FabioCL/analog_synth/simulations/LMx58B_LM2904B_PSpice/LMx58B_LM2904B-PSpiceFiles/SCHEMATIC1/Transient/Transient.cir

** Profile: "SCHEMATIC1-Transient"  [ C:\Users\a0232807\Documents\Modeling\model_fix_reupload\LMx58B_LM2904B-PSpiceFiles\SCHEMATIC1\Transient.sim ] 

** Creating circuit file "Transient.cir" 
** WARNING: THIS AUTOMATICALLY GENERATED FILE MAY BE OVERWRITTEN BY SUBSEQUENT SIMULATIONS

*Libraries: 
* Profile Libraries :
* Local Libraries :
.LIB "../../../fixed_models/lmx58b_lm2904b.lib" 
* From [PSPICE NETLIST] section of C:\cds_spb_home\cdssetup\OrCAD_PSpiceTIPSpice_Install\17.4.0\PSpice.ini file:
.lib "nom_pspti.lib" 
.lib "nom.lib" 

*Analysis directives: 
.TRAN  0 1m 0 
.OPTIONS ADVCONV
.OPTIONS FILEMODELSEARCH
.PROBE64 N([VO])
.PROBE64 N([VIN])
.INC "..\SCHEMATIC1.net" 


.END
