FabioCL/analog_synth/simulations/main_trim_and_linexp.asc

C3: cap; 1n
Q3: npn; BC547C
Q4: npn; BC547C
R1: res; 1200k
R2: res; 100k
R3: res; 2.2k
R4: res; 1
R5: res; 623
R6: res; 15k
R7: res; 100k
R8: res; 100k
R9: res; 10k
R10: res; 1
R11: res; 1780
U1: LMX58B_LM2904B
U2: LMX58B_LM2904B
U4: LMX58B_LM2904B
V5: voltage; {vpitch_val}
V6: voltage; -12V
V7: voltage; 12V
V8: voltage; 5V
X1: pot; R=100k val=50
X2: pot; R=100k val=50
Named nets: 0, Vneg, Vpos, CV_out, Vpitch, GND, VCC, Vpitch_trim
based on https://www.schmitzbits.de/expo_tutorial/
Create audio files
https://www.analog.com/en/analog-dialogue/raqs/raq-issue-175.html
Linear to Exponential Converter
1st order Temp compensation: Current mirror Is argument
The exponentiator has the lowest
 temperature dependancy
when operated arround Is
( reference current).
2nd order Temp Comp: exp argument
Rbe effect (Rossum compensation)
Coarse
Fine
Pitch 1V/oct
.step param vpitch_val 0 5 1
.op
No Temperature compensation (25C assumed)
just for visualization
