FabioCL/analog_synth/simulations/main_ADSR.asc

20: res; 20k
C1: cap; 470p
C2: cap; 4.7µ
C3: cap; 470p
C4: cap; 220n
C5: cap; 33n
D1: diode; 1N914
D2: diode; 1N914
D3: diode; 1N914
D4: diode; 1N914
D5: diode; 1N914
D6: diode; 1N914
D7: diode; 1N914
D8: diode; 1N914
D9: diode; 1N914
D10: diode; 1N914
D11: diode; 1N914
D12: diode; 1N914
D13: diode; 1N914
D14: diode; 1N914
D16: diode; 1N914
Q1: npn; BC847B
Q2: npn; BC847B
Q3: pnp; 2N2907
Q4: npn; BC847B
Q5: npn; BC847B
Q6: pnp; 2N2907
Q7: pnp; 2N2907
Q8: npn; BC847B
Q9: pnp; 2N2907
R1: res; 1k
R2: res; 50000k
R3: res; 39k
R4: res; 39k
R5: res; 1000k
R6: res; 270k
R7: res; 100k
R8: res; 39k
R9: res; 39k
R10: res; 100k
R11: res; 20k
R12: res; 270k
R13: res; 27k
R14: res; 1000k
R15: res; 270k
R16: res; 3.6k
R17: res; 20k
R18: res; 39k
R19: res; 39k
R20: res; 39k
R21: res; 270k
R22: res; 100
R23: res; 270k
R26: res; 10k
R27: res; 30k
R28: res; 50.1k
R29: res; 10k
R30: res; 100k
U1: UniversalOpAmp
U2: UniversalOpAmp
V2: voltage; PULSE(0 5 1 100p 0 1)
V6: voltage; -12V
V7: voltage; 12V
X1: pot; R=5000k val=80
X2: pot; R=1000k val=90
X3: pot; R=1000k val=50
X4: pot; R=100k val=50
X6: pot; R=1k val=10
Named nets: 0, Vneg, Vpos, gate_in, B, B_plus, Q, A_plus, Cbuf, C, OUT_aux, OUT, OUT_INV, OUT_AMT
.tran 10 startup
Input SCHMITT
ADSR driver
MMBT2907A - sot23
SUSTAIN level
ATTACK time
RELEASE time
DECAY time
Output SCHMITT
Attack Flip-flop
OUTPUT buffer
Cbuf is a sample of the
 output voltage
Goes low when ATTACK ends (Cout = 8v)
Positive pulse when B goes high
Q keeps track of the ATTACK phase.
between pulses B_plus and A_plus (turns OFF)
