FabioCL/analog_synth/simulations/Draft1.asc

D1: diode
D2: diode
D3: diode
M1: pmos; IRF7220
M2: nmos; BSC059N04LS6
M3: nmos; BSC059N04LS6
M4: nmos; BSC059N04LS6
R1: res; 10
R2: res; 10
R3: res; 10
V1: voltage; PULSE(0 3.3 0.5 0 0 1 6)
V2: voltage; PULSE(0 3.3 1 0 0 1 3)
V3: voltage; 3.3V
V4: voltage; PULSE(0 3.3 1 0 0 1 3)
V5: voltage; PULSE(0 3.3 1 0 0 1 3)
Named nets: 0, EN, VCC, CLR1, CLR3, CLR2, LED1, LED2, LED3, LEDs_EN
.tran 10
