FabioCL/analog_synth/simulations/main_LPF_Ladder.asc

C1: cap; 1µ
C2: cap; 1n
C3: cap; 1n
C4: cap; 1n
C5: cap; 1n
C6: cap; 1n
C7: cap; 1µ
D1: diode; 1N914
D2: diode; 1N914
D3: diode; 1N914
D4: diode; 1N914
D5: diode; 1N914
D6: diode; 1N914
D7: diode; 1N914
D8: diode; 1N914
D9: diode; 1N914
D10: diode; 1N914
D11: diode; 1N914
R1: res; 1k
R2: res; 4.7k
R3: res; 100
R4: res; 47k
R5: res; 47k
R6: res; 47k
R7: res; 47k
R8: res; 47k
R9: res; 47k
R10: res; 1k
R11: res; 47k
R12: res; 100k
R13: res; 47k
R14: res; 1k
R15: res; 47k
R17: res; 10k
R18: res; 2.7k
U1: LMX58B_LM2904B
U2: LMX58B_LM2904B
U3: LMX58B_LM2904B
U4: LMX58B_LM2904B
U5: LMX58B_LM2904B
U6: LMX58B_LM2904B
U7: LMX58B_LM2904B
V1: voltage; ""; AC 1
V2: voltage; 12
V3: voltage; PULSE(-5 5 0 1p 1p {wton} {wperiod})
V6: voltage; -12V
V7: voltage; 12V
X1: pot; R=100k val={cutf_val}
X2: pot; R=100k val=50
Named nets: 0, Vneg, Vpos, signalwave, offset, ladder_p, CV_CUT_OFF, signal_buffer, ladder_n, ladder_out, amp_out, ladder_buff, ladder_res_out, ladder_res, VIN, VOUT
.ac dec 999 10 20k
Wave Preparation
 - HP filter (DC remove)
 - Signal down scaling (prevent ladder to become a short circuit " resistor too low")
Diode LADDER
Gain = 1, Positive offset
Inverter Summer
100mVpp
output gain stage
CV Processing - Cutoff Frequency / Change "diode" resistance
Ressonance
;.step param res_val 10 90 80
reduce diodes effective resistances  (voltage controlled resistor)
.param wfreq=1200 wperiod=1/wfreq wton=wperiod*0.5
.step param cutf_val 10 90 10
