FabioCL/analog_synth/simulations/main_SAW_to_PULSE_PWM_SQUARE.asc

C1: cap; 10n
R1: res; 1k
R2: res; 100k
R3: res; 1k
R4: res; 1k
R5: res; 2.4k
U1: TL07XH_TL08XH
U2: TL07XH_TL08XH
V1: voltage; PULSE(-5 5 0 {period} 0 0 {period})
V2: voltage; 5V
V6: voltage; -12V
V7: voltage; 12V
X1: pot; R=100k val=50
Named nets: 0, Vneg, Vpos, Vsaw_in, Vpulse, Vcc, Vpulse_out
.tran 12ms
.param period=1/110
DC control
Output range: -5V to 5V
Output: 0
