FabioCL/analog_synth/simulations/main_SAW_to_SQUARE.asc

U1: TL07XH_TL08XH
V4: voltage; PULSE(-2.4 2.4 0 {triangle_period/2} {triangle_period/2} 0 {triangle_period})
V6: voltage; -12V
V7: voltage; 12V
Named nets: 0, Vneg, Vpos, Vtriangle_in, Vsine
.tran 12ms
Saw to Sine (OTA)
https://www.youtube.com/watch?v=V_AzBAopRS8&list=PLOunECWxELQS5bMdWo9VhmZtsCjhjYNcV&index=19
.param triangle_period={1/val}
Sine wave
 - Linearizing diode, 1mA bias is recommended, (12 - 0.7V)  10k recommended
 - gm = 19.2* Iabc
.step param val list 220 880
