FabioCL/analog_synth/simulations/main_SAW_to_TRIAN.asc

C1: cap; 100p
C2: cap; 100p
D2: diode; 1N914
D3: diode; 1N914
R1: res; 10k
R2: res; 10k
R3: res; 10k
R4: res; 10k
R5: res; 10k
R6: res; 1k
R7: res; 4.7k
R8: res; 10k
R9: res; 20k
R10: res; 1k
R11: res; 1k
U1: TL07XH_TL08XH
U2: TL07XH_TL08XH
U3: TL07XH_TL08XH
U5: TL07XH_TL08XH
V1: voltage; 1.2
V2: voltage; PULSE(0 4.8 0 {period} 0 0 {period})
V3: voltage; 1.2
V6: voltage; -12V
V7: voltage; 12V
Named nets: 0, Vneg, Vpos, Vsaw_in, Vsaw_ac_inv, Vref, Vtriangle_AC, Vsaw_ac, Voffset, Vtriangle_out, Vsaw_out
VCO  (Exp input) based on
.param period=1/220
.tran 12ms
trimming
SAW/Ramp wave
Saw to Pulse Wave ( Moog Werkstatt)
https://www.youtube.com/watch?v=qsaLmGgiVcU
Triangle wave
Output Range: 0 to 5V
Phase: 0deg
