FabioCL/analog_synth/simulations/main_TRIAN_to_SINE2.asc

C1: cap; 1µ
D1: diode; 1N914
D2: diode; 1N914
R10: res; 10k
R11: res; 10k
R12: res; 2.2k
R13: res; 10k
U2: TL07XH_TL08XH
V4: voltage; PULSE(-5 5 0 {triangle_period/2} {triangle_period/2} 0 {triangle_period})
V6: voltage; -12V
V7: voltage; 12V
X1: pot; R=100k val=90
Named nets: 0, Vneg, Vpos, Vtriangle_in, sine_wave_ac
.tran 0 100ms 60ms uic
.param triangle_period={1/val}
.step param val list 220 880
;.step param r_val 10k 100k 10k
Variable - Gain
Variable - Curvature
