FabioCL/analog_synth/simulations/main_trim.asc

B1: bv; V=(V(vpitch_trim))-(V(vpitchref))
B2: bv; V=-V(vpitch)*({Ru}/{Rin})
R1: res; 1100
R2: res; 8250
R5: res; 100k
R6: res; 1k
R7: res; 100k
R8: res; 1100
R9: res; 8250
R10: res; 100k
U1: LMX58_LM2904
U2: TFPT0805L2201; TOL25=1 TOLslope=0
U3: TFPT0805L2201; TOL25=1 TOLslope=0
V1: voltage; {vpitch_val}
V2: voltage; -12V
V3: voltage; 12V
V4: voltage; 5V
V6: voltage; 1V
X1: pot; R=100k val=49.171
X2: pot; R=100k val=50
Named nets: Vneg, Vpos, Vpitch, Vpitch_trim, GND, 0, vpitch_error, VCC, vpitchref, 1V0_B
Control Voltage
Coarse
Fine
Pitch 1V/oct
Note: 
To get 1V / octave. Gain should be 18mV/V 
(required by the transistor next stage)
 
Opamp offset fixed by course and fine tune
.meas VtrimAvg AVG V(vpitch_trim)/V(vpitch)
.step param vpitch_val 0.5 5 0.5
.op
.param Rin=100k Ru=1.8k
Temperature compensation
.TEMP 10 25 45
