FabioCL/analog_synth/simulations/main_trim_and_linexp_temp.asc

R2: res; 100k
R7: res; 100k
R8: res; 100k
R9: res; 10k
R12: res; 1100
R13: res; 8250
U2: LMX58_LM2904
U5: TFPT0805L2201; TOL25=1 TOLslope=0
V5: voltage; {vpitch_val}
V6: voltage; -12V
V7: voltage; 12V
V8: voltage; 5V
X1: pot; R=100k val=50
X2: pot; R=100k val=50
Named nets: Vneg, Vpos, Vpitch, Vpitch_trim, GND, 0, VCC
based on https://www.schmitzbits.de/expo_tutorial/
Linear to Exponential Converter
Coarse
Fine
Pitch 1V/oct
Note: 
To get 1V / octave. Gain should be 18mV/V 
(required by the transistor next stage)
 
Opamp offset fixed by course and fine tune
.step param vpitch_val 0.5 5 0.5
.op
Temperature compensation
.TEMP 10 25 45
