FabioCL/analog_synth/simulations/main_VCA_exp.asc

Q3: npn; BC547C
Q4: npn; BC547C
R1: res; 10k
R2: res; 100
R3: res; 47
R4: res; 6.8kk
R5: res; 100k
R6: res; 10k
R7: res; 10k
R8: res; 10k
R9: res; 47k
R10: res; 100k
R11: res; 47k
R12: res; 100k
R13: res; 6.8k
U1: TL07XH_TL08XH
U2: TL07XH_TL08XH
V1: voltage; EXP(0 5 0 1 2 1)
V2: voltage; PULSE(0 5 0 2 2 1)
V3: voltage; SINE(0 5 100)
V4: voltage; -400m
V6: voltage; -12V
V7: voltage; 12V
Named nets: 0, Vpos, Vneg, CV_in_notused, signalwave, CV_in, vout1, vout2, emit, vout, Vr
.tran 2s
Vin Signal -5 to 5V
AMP mag input
Vctrl Signal -5 to 5V
ADSR input
;.wave test1.wave 16 44100 vout
;.wave test1.wav 16 44100 vout
Define exponential curvature / acentuation
gain relation / Lin to Exp
TODO:add 1v offset
Vout = Vr + ((Rf/R1) * (V2 -V1))
