FabioCL/analog_synth/simulations/main_VCA_linear.asc

Q3: npn; BC547C
Q4: npn; BC547C
R1: res; 10k
R2: res; 100
R3: res; 1k
R4: res; 10k
R5: res; 100k
R6: res; 10k
R7: res; 100k
R8: res; 100k
R9: res; 360k
R10: res; 100k
R11: res; 360k
U1: TL07XH_TL08XH
U2: TL07XH_TL08XH
V1: voltage; PULSE(0 12 0 100m 0 0.1)
V3: voltage; SINE(0 5 440)
V6: voltage; -12V
V7: voltage; 12V
Named nets: 0, Vpos, Vneg, CV_in, signalwave, vout1, vout2, emit, vout
based on https://www.schmitzbits.de/expo_tutorial/
Linear to Exponential Converter
.tran 100m
Vin Signal -5 to 5V
AMP mag input
Vctrl Signal -5 to 5V
ADSR input
.wave
