FabioCL/analog_synth/simulations/main_VCA_linear_transistorbased.asc

Q3: npn; BC547C
Q4: npn; BC547C
R1: res; 10k
R2: res; 100
R3: res; 1k
R4: res; 47k
R5: res; 100k
R6: res; 10k
R7: res; 10k
R8: res; 10k
R9: res; 68k
R10: res; 100k
R11: res; 68k
U1: TL07XH_TL08XH
U2: TL07XH_TL08XH
V1: voltage; EXP(0 5 0 1 2 1)
V3: voltage; SINE(0 5 440)
V6: voltage; -12V
V7: voltage; 12V
Named nets: 0, Vpos, Vneg, CV_in, signalwave, vout1, vout2, emit, vout
.tran 10s
Vin Signal -5 to 5V
AMP mag input
Vctrl Signal -5 to 5V
ADSR input
brief ADSR sim
.wave test1.wave 16 44100 vout
.wave test1.wav 16 44100 vout
