FabioCL/analog_synth/simulations/main_VCO_SAW.asc

C1: cap; 1µ
C2: cap; 2.2n
C3: cap; 22p
I1: current; 1.98E-05
J2: njf; 2N4859
R1: res; 22k
R2: res; 2.2k
R3: res; 100k
R4: res; 10k
R5: res; 20k
R6: res; 1k
R7: res; 10k
R8: res; 10k
R9: res; 1k
U1: TL07XH_TL08XH
U2: LM311
U3: TL07XH_TL08XH
U4: TL07XH_TL08XH
V6: voltage; -12V
V7: voltage; 12V
X1: pot; R=100k val=33.2
X2: pot; R=100k val=43
Named nets: 0, Vneg, Vpos, Vsaw, Vpulse, Vsaw_out_inv, Vsaw_out
https://www.youtube.com/watch?v=qF4G4QfC9dM&list=PLOunECWxELQS5bMdWo9VhmZtsCjhjYNcV&index=12
VCO  (Exp input) based on
;step param ifreq list 1.98E-05 3.96E-05 7.92E-05 1.58E-04 3.17E-04
.tran 100m
Vgs(OFF) = -2.2V
.MODEL 2N4859 njf VTO=-4.92 BETA=2.42m LAMBDA=25.4m CGD=10.9p CGS=10.9p PB=1.68 IS=22.1f MFG=InterFET
Output Range: -5 to 5V
Phase: 0deg
Output Range: -5  to 5V
Phase: 180deg
