FabioCL/analog_synth/simulations/pot.asc

R1: res; {x1}
R2: res; {x2}
Named nets: 1, 3, 2
.param x1 = R*(val/100)
.param x2=R*(1-(val/100))
