FabioCL/analog_synth/simulations/ltspice_ntc_tfpt_pts_model/Draft1.asc

R1: res; 450
R2: res; 2000
U1: NTCS0805E3102_LT
V1: voltage; 10
Named nets: 0
.dc TEMP -40 125 1
