FabioCL/analog_synth/simulations/ltspice_ntc_tfpt_pts_model/simulation_LT_therm_Vishay.asc

R1: res; 1k
R2: res; 8k
R3: res; 10k
U1: TFPT1206L1002; TOL25=1 TOLslope=1
U3: PTS12060__1K00; TOL0=0.6 TOLS=0.01
U4: NTCS0805E3102_LT; NTCS0603E3102_LT; TR=5 TB=1
V1: voltage; 0.2
V2: voltage; 0.2
V3: voltage; 0.2
Named nets: 0, TFPT, PTS, NTC
.dc TEMP -55 150 1
.param run=1
.step param run 1 100 1
.meas Rt1 find -V(TFPT)/I(V1) at=-55
.meas Rt2 find -V(TFPT)/I(V1) at=25
.meas Rt3 find -V(TFPT)/I(V1) at=85
.meas Rt4 find -V(TFPT)/I(V1) at=150
.meas Rn1 find -V(NTC)/I(V3) at=-55
.meas Rn2 find -V(NTC)/I(V3) at=25
.meas Rn3 find -V(NTC)/I(V3) at=85
.meas Rn4 find -V(NTC)/I(V3) at=150
.meas Rp1 find -V(PTS)/I(V2) at=-55
.meas Rp2 find -V(PTS)/I(V2) at=0
.meas Rp3 find -V(PTS)/I(V2) at=85
.meas Rp4 find -V(PTS)/I(V2) at=150
.meas B PARAM -ln(Rn2/Rn3)/(1/358.15-1/298.15)
This simulation is computing and displaying the voltages 
across an NTC Thermistor, across a TFPT RTD and also
a PTS RTD in a voltage divider (Vcc= 0.2 V in order to 
avoid self heating) , for temperatures swept between -55°C
and 150°C.  100 runs are performed,the tolerances being 
modelled according to Monte Carlo distribution.
In the MEAS section , resistances are computed at different
temperatures (-55°C/150°C) .When the simulation is completed ,
open "view" then "Spice Error Log" for display.
