FabioCL/analog_synth/(list of files, drawings)

Other design files:
simulations/LMx58B_LM2904B_PSpice/lmx58b_lm2904b.dsn
simulations/LMx58B_LM2904B_PSpice/lmx58b_lm2904b.opj
