FabioCL/analog_synth/hardware/kicad_project/hybrid_core_module/midi_vco_module/midi_vco_module.kicad_pcb

## KiCad design hardware/kicad_project/hybrid_core_module/midi_vco_module/midi_vco_module.kicad_pcb (2025-11-15)

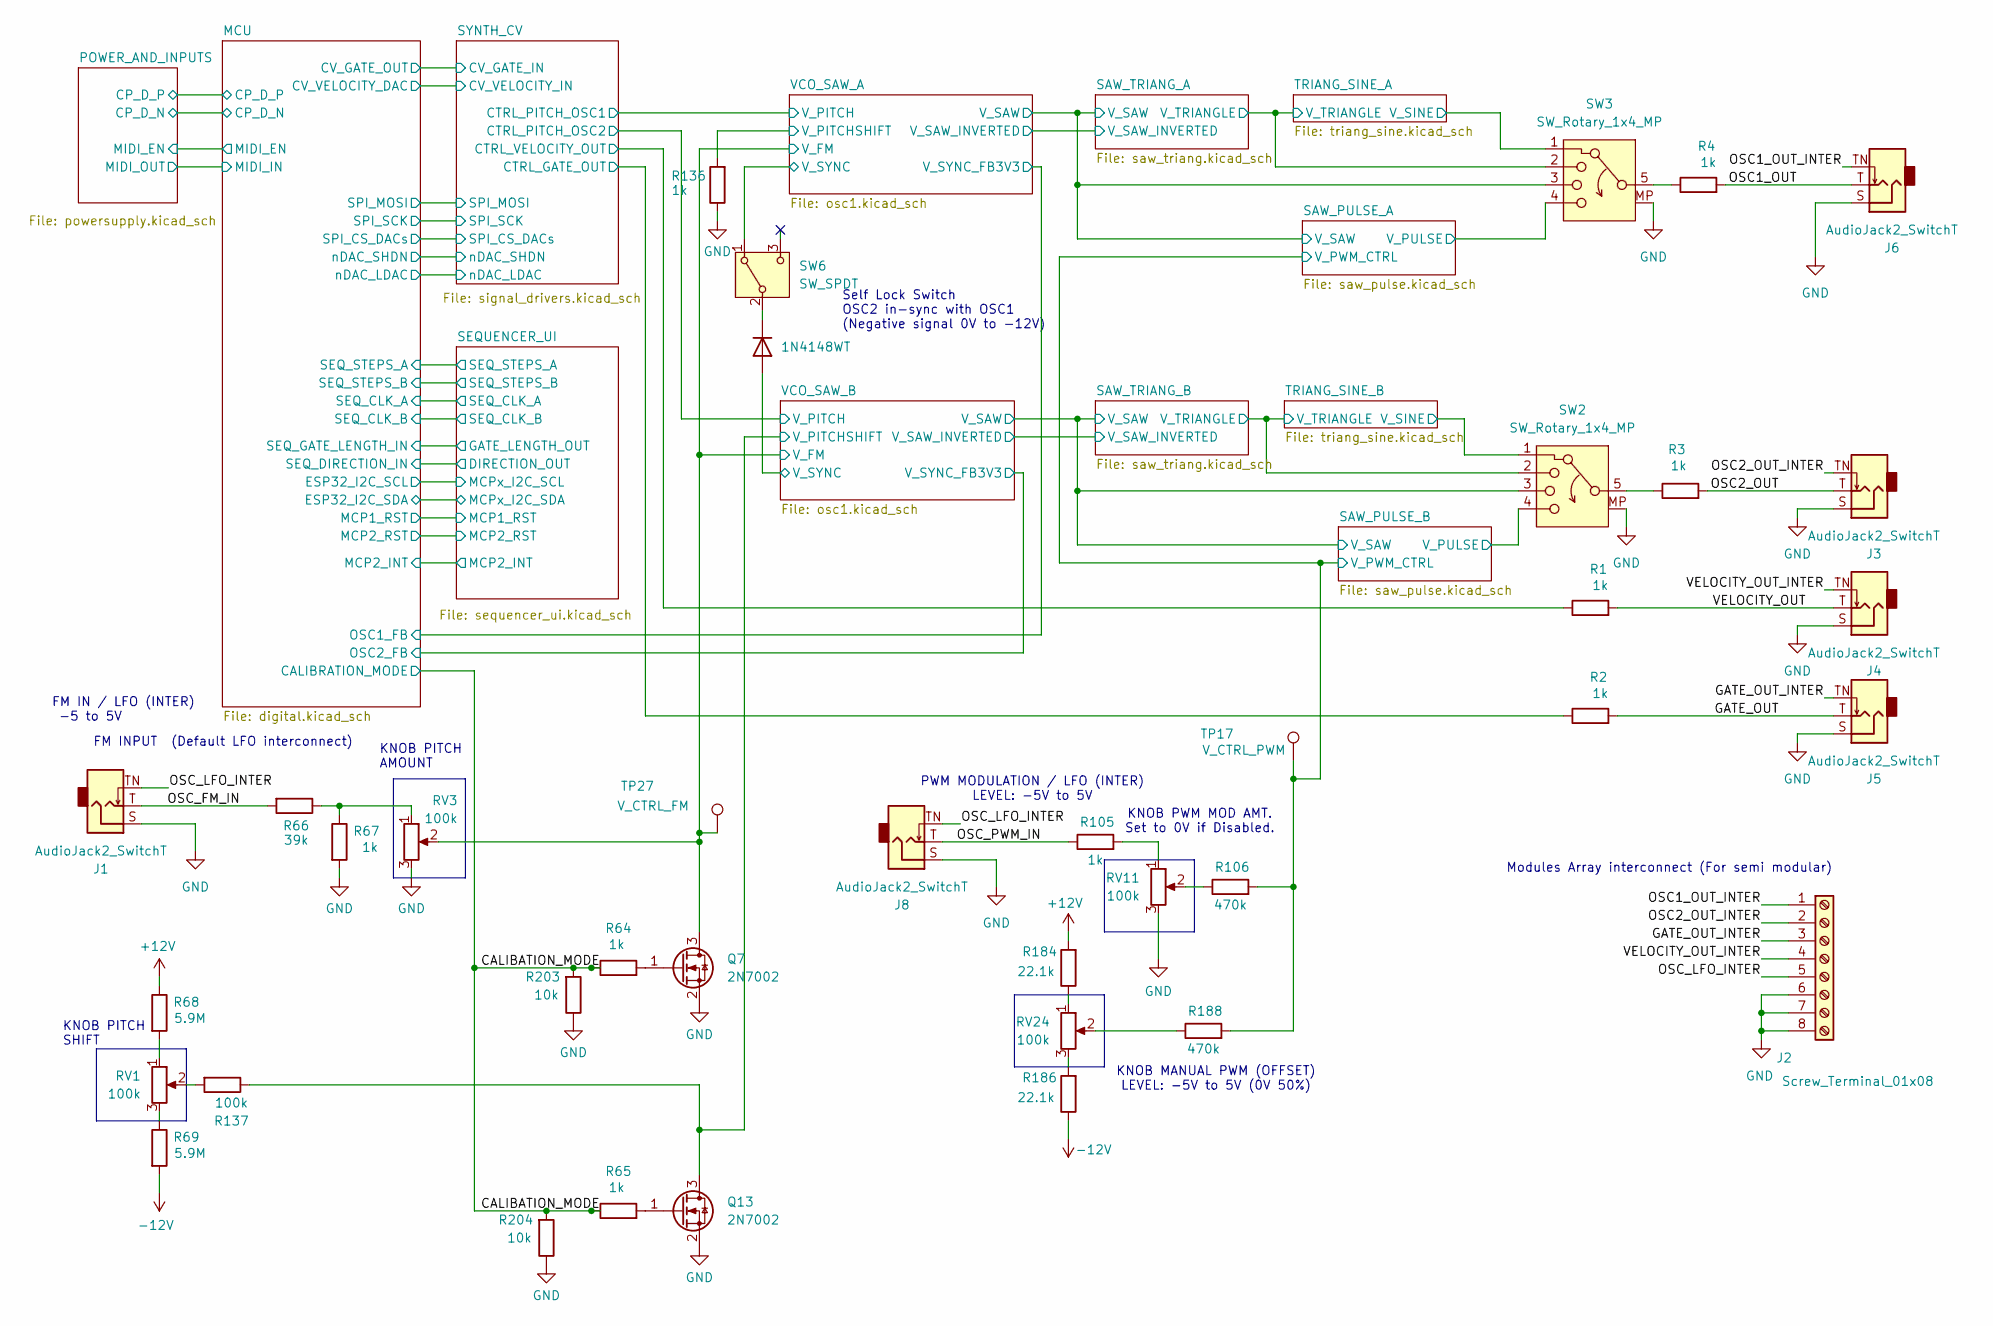
[picture p1: schematic midi_vco_module.kicad_sch]

Parts:
D1: 1N4148WT; D_SOD-523; Manufacturer PartNumer 1N4148WT
J1, J3, J4, J5, J6, J8: AudioJack2_SwitchT; Jack_3.5mm_QingPu_WQP-PJ398SM_Vertical_CircularHoles; Manufacturer PartNumer WQP-PJ398SM
J2: Screw_Terminal_01x08; TerminalBlock_CUI_TB007-508-08_1x08_P5.08mm_Horizontal; Manufacturer PartNumer TB007-508-08BE
Q7, Q13: 2N7002; SOT-23; Manufacturer PartNumer 2N7002
R1, R2, R3, R4, R64, R65, R67, R105, R136: 1k; R_0402_1005Metric; Manufacturer PartNumer RT0402FRE071KL
R66: 39k; R_0402_1005Metric; Manufacturer PartNumer RT0402FRE0739KL
R68, R69: 5.9M; R_0402_1005Metric; Manufacturer PartNumer RC0402FR-075M9L
R106, R188: 470k; R_0402_1005Metric; Manufacturer PartNumer RC0402FR-7D470KL
R137: 100k; R_0402_1005Metric; Manufacturer PartNumer RT0402FRE07100KL
R184, R186: 22.1k; R_0402_1005Metric; Manufacturer PartNumer RT0402FRE0721KL
R203, R204: 10k; R_0402_1005Metric; Manufacturer PartNumer RT0402FRE0710KL
RV1, RV3, RV11, RV24: 100k; Potentiometer_RV09_Single_Vertical; Manufacturer PartNumer 3296W-104-LF
SW2, SW3: SW_Rotary_1x4_MP; SR16 Rotary Band Switch; Manufacturer PartNumer SR16
SW6: SW_SPDT; SW_Toggle_Blue_wSlots; Manufacturer PartNumer MTS-102
TP17: V_CTRL_PWM; TestPoint_Pad_1.0x1.0mm
TP27: V_CTRL_FM; TestPoint_Pad_1.0x1.0mm

Connections:
+12V: R68.1, R184.2; also elsewhere on the board
-12V: R69.2, R186.1; also elsewhere on the board
/CALIBATION_MODE: R64.1, R65.1, R203.2, R204.2; also elsewhere on the board
/GATE_OUT: J5.T, R2.2
/GATE_OUT_INTER: J2.3, J5.TN
/OSC1_OUT: J6.T, R4.2
/OSC1_OUT_INTER: J2.1, J6.TN
/OSC2_OUT: J3.T, R3.2
/OSC2_OUT_INTER: J2.2, J3.TN
/OSC_FM_IN: J1.T, R66.2
/OSC_LFO_INTER: J1.TN, J2.5, J8.TN
/OSC_PWM_IN: J8.T, R105.1
/SAW_PULSE_A/V_PULSE: SW3.4; also elsewhere on the board
/SAW_PULSE_A/V_PWM_CTRL: R106.2, R188.2, TP17.1; also elsewhere on the board
/SAW_PULSE_A/V_SAW: SW3.3; also elsewhere on the board
/SAW_PULSE_B/V_PULSE: SW2.4; also elsewhere on the board
/SAW_PULSE_B/V_SAW: SW2.3; also elsewhere on the board
/SAW_TRIANG_A/V_TRIANGLE: SW3.2; also elsewhere on the board
/SAW_TRIANG_B/V_TRIANGLE: SW2.2; also elsewhere on the board
/SYNTH_CV/CTRL_GATE_OUT: R2.1; also elsewhere on the board
/SYNTH_CV/CTRL_VELOCITY_OUT: R1.1; also elsewhere on the board
/TRIANG_SINE_A/V_SINE: SW3.1; also elsewhere on the board
/TRIANG_SINE_B/V_SINE: SW2.1; also elsewhere on the board
/VCO_SAW_A/V_FM: Q7.3 (D), RV3.2, TP27.1; also elsewhere on the board
/VCO_SAW_A/V_PITCHSHIFT: R136.2; also elsewhere on the board
/VCO_SAW_A/V_SYNC: SW6.1 (A); also elsewhere on the board
/VCO_SAW_B/V_PITCHSHIFT: Q13.3 (D), R137.1; also elsewhere on the board
/VCO_SAW_B/V_SYNC: D1.2 (A); also elsewhere on the board
/VELOCITY_OUT: J4.T, R1.2
/VELOCITY_OUT_INTER: J2.4, J4.TN
GND: J1.S, J2.6, J2.7, J2.8, J3.S, J4.S, J5.S, J6.S, J8.S, Q7.2 (S), Q13.2 (S), R67.2, R136.1, R203.1, R204.1, RV3.3, RV11.3, SW2.MP, SW3.MP; also elsewhere on the board
unnamed: D1.1 (K), SW6.2 (B)
unnamed: Q7.1 (G), R64.2
unnamed: Q13.1 (G), R65.2
unnamed: R3.1, SW2.5
unnamed: R4.1, SW3.5
unnamed: R66.1, R67.1, RV3.1
unnamed: R68.2, RV1.1
unnamed: R69.1, RV1.3
unnamed: R105.2, RV11.1
unnamed: R106.1, RV11.2
unnamed: R137.2, RV1.2
unnamed: R184.1, RV24.1
unnamed: R186.2, RV24.3
unnamed: R188.1, RV24.2

Notes on the sheet:
KNOB PITCH SHIFT
KNOB PWM MOD AMT. Set to 0V if Disabled.
Self Lock Switch OSC2 in-sync with OSC1 (Negative signal 0V to -12V)
PWM MODULATION / LFO (INTER) LEVEL: -5V to 5V
FM INPUT (Default LFO interconnect)
KNOB MANUAL PWM (OFFSET) LEVEL: -5V to 5V (0V 50%)
KNOB PITCH AMOUNT
FM IN / LFO (INTER) -5 to 5V
Modules Array interconnect (For semi modular)

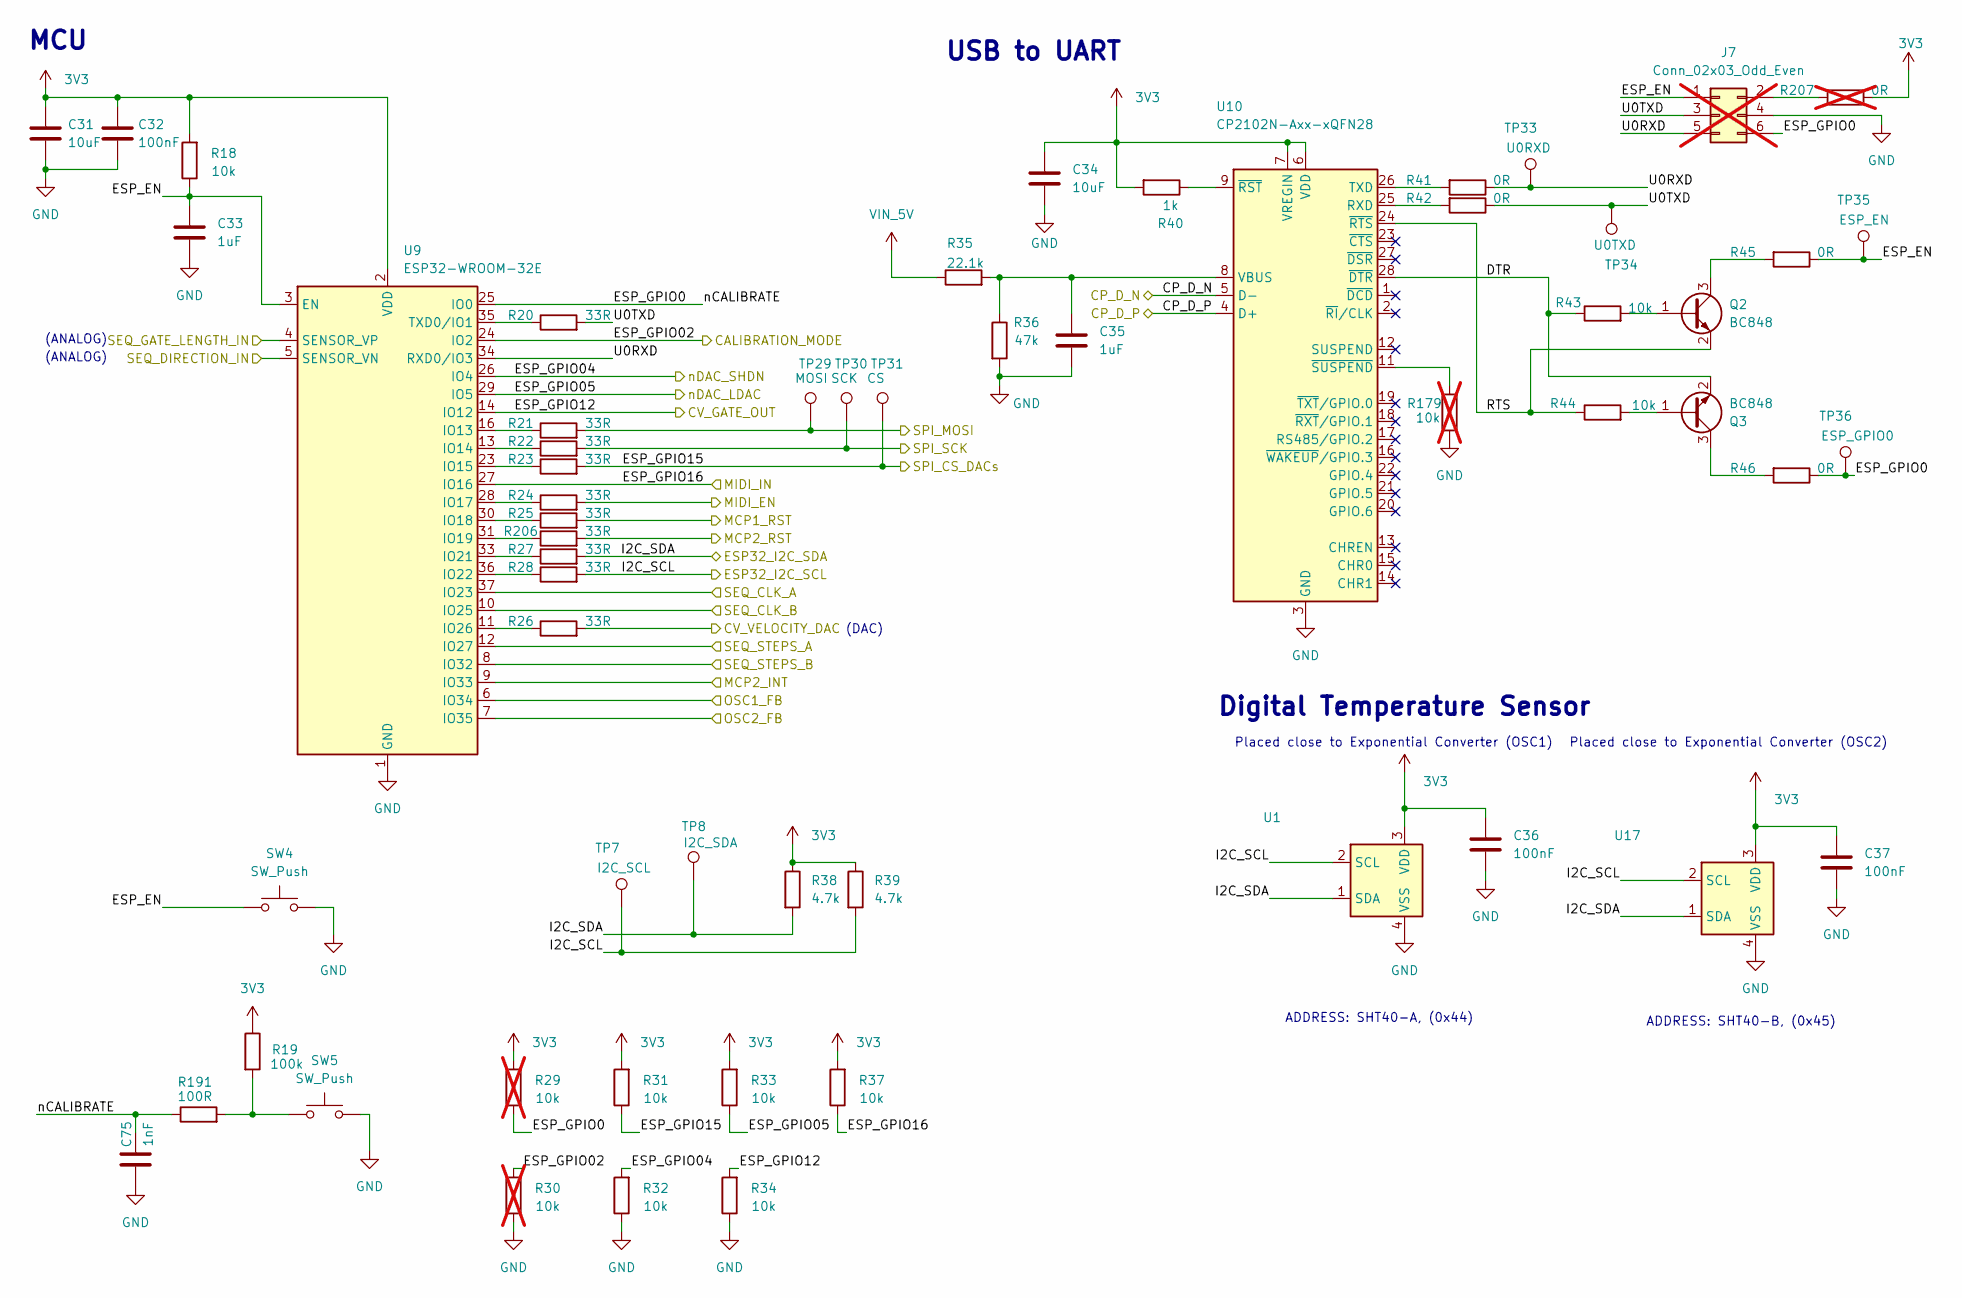
[picture p2: schematic digital.kicad_sch]

Parts:
C31, C34: 10uF; C_0805_2012Metric; Manufacturer PartNumer GRM21BR61E106KA73K
C32, C36, C37: 100nF; C_0402_1005Metric; Manufacturer PartNumer GRM155R71E104KE14J
C33, C35: 1uF; C_0805_2012Metric; Manufacturer PartNumer GRM219R71E105MA88J
C75: 1nF; C_0402_1005Metric; Manufacturer PartNumer GRM155R71E103KA01J
J7: Conn_02x03_Odd_Even; PinHeader_2x03_P1.27mm_Vertical_SMD; not fitted
Q2, Q3: BC848; SOT-23; Manufacturer PartNumer BC848A
R18, R31, R32, R33, R34, R37, R43, R44: 10k; R_0402_1005Metric; Manufacturer PartNumer RT0402FRE0710KL
R19: 100k; R_0402_1005Metric; Manufacturer PartNumer RT0402FRE07100KL
R20, R21, R22, R23, R24, R25, R26, R27, R28, R206: 33R; R_0402_1005Metric; Manufacturer PartNumer RT0402FRE0733RL
R29, R30, R179: 10k; R_0402_1005Metric; Manufacturer PartNumer RT0402FRE0710KL; not fitted
R35: 22.1k; R_0402_1005Metric; Manufacturer PartNumer RT0402FRE0721KL
R36: 47k; R_0402_1005Metric; Manufacturer PartNumer RT0402FRE0747KL
R38, R39: 4.7k; R_0402_1005Metric; Manufacturer PartNumer RT0402FRE074K7L
R40: 1k; R_0402_1005Metric; Manufacturer PartNumer RT0402FRE071KL
R41, R42, R45, R46: 0R; R_0402_1005Metric; Manufacturer PartNumer RC0402FR-070RL
R191: 100R; R_0402_1005Metric; Manufacturer PartNumer RT0402FRE07100RL
R207: 0R; R_0402_1005Metric; Manufacturer PartNumer RC0402FR-070RL; not fitted
SW4, SW5: SW_Push; SW_PUSH_6mm
TP7: I2C_SCL; TestPoint_Pad_1.0x1.0mm
TP8: I2C_SDA; TestPoint_Pad_1.0x1.0mm
TP29: MOSI; TestPoint_Pad_1.0x1.0mm
TP30: SCK; TestPoint_Pad_1.0x1.0mm
TP31: CS; TestPoint_Pad_1.0x1.0mm
TP33: U0RXD; TestPoint_Pad_1.0x1.0mm
TP34: U0TXD; TestPoint_Pad_1.0x1.0mm
TP35: ESP_EN; TestPoint_Pad_1.0x1.0mm
TP36: ESP_GPIO0; TestPoint_Pad_1.0x1.0mm
U1: SHT4x; Sensirion_DFN-4_1.5x1.5mm_P0.8mm_SHT4x_NoCentralPad; Manufacturer PartNumer SHT40-AD1B-R3
U9: ESP32-WROOM-32E; ESP32-WROOM-32D; Manufacturer PartNumer ESP32-WROOM-32E-N8
U10: CP2102N-Axx-xQFN28; QFN-28-1EP_5x5mm_P0.5mm_EP3.35x3.35mm; Manufacturer PartNumer CP2102N-A02-GQFN28R
U17: SHT4x; Sensirion_DFN-4_1.5x1.5mm_P0.8mm_SHT4x_NoCentralPad; Manufacturer PartNumer SHT40-BD1B-R3

Connections:
3V3: C31.1, C32.1, C34.1, C36.1, C37.1, R18.2, R19.1, R29.2, R31.2, R33.2, R37.2, R38.1, R39.1, R40.2, R207.1, U1.3 (VDD), U9.2 (VDD), U10.6 (VDD), U10.7 (VREGIN), U17.3 (VDD); also elsewhere on the board
/CALIBATION_MODE: R30.2, U9.24 (IO2); also elsewhere on the board
/MCU/CP_D_N: U10.5 (D-); also elsewhere on the board
/MCU/CP_D_P: U10.4 (D+); also elsewhere on the board
/MCU/CV_VELOCITY_DAC: R26.2; also elsewhere on the board
/MCU/DTR: Q3.2 (E), R43.1, U10.28 (~DTR)
/MCU/ESP_EN: C33.1, J7.1, R18.1, R45.1, SW4.1, TP35.1, U9.3 (EN)
/MCU/ESP_GPIO0: C75.2, J7.6, R29.1, R46.1, R191.1, TP36.1, U9.25 (IO0)
/MCU/ESP_GPIO04: R32.2, U9.26 (IO4); also elsewhere on the board
/MCU/ESP_GPIO05: R33.1, U9.29 (IO5); also elsewhere on the board
/MCU/ESP_GPIO12: R34.2, U9.14 (IO12); also elsewhere on the board
/MCU/ESP_GPIO15: R23.2, R31.1, TP31.1; also elsewhere on the board
/MCU/ESP_GPIO16: R37.1, U9.27 (IO16); also elsewhere on the board
/MCU/I2C_SCL: R28.2, R39.2, TP7.1, U1.2 (SCL), U17.2 (SCL); also elsewhere on the board
/MCU/I2C_SDA: R27.2, R38.2, TP8.1, U1.1 (SDA), U17.1 (SDA); also elsewhere on the board
/MCU/MCP2_INT: U9.9 (IO33); also elsewhere on the board
/MCU/MCP2_RST: R206.2; also elsewhere on the board
/MCU/MIDI_EN: R24.2; also elsewhere on the board
/MCU/OSC1_FB: U9.6 (IO34); also elsewhere on the board
/MCU/OSC2_FB: U9.7 (IO35); also elsewhere on the board
/MCU/RTS: Q2.2 (E), R44.1, U10.24 (~RTS)
/MCU/SEQ_CLK_A: U9.37 (IO23); also elsewhere on the board
/MCU/SEQ_CLK_B: U9.10 (IO25); also elsewhere on the board
/MCU/SEQ_DIRECTION_IN: U9.5 (SENSOR_VN); also elsewhere on the board
/MCU/SEQ_GATE_LENGTH_IN: U9.4 (SENSOR_VP); also elsewhere on the board
/MCU/SEQ_STEPS_A: U9.12 (IO27); also elsewhere on the board
/MCU/SEQ_STEPS_B: U9.8 (IO32); also elsewhere on the board
/MCU/U0RXD: J7.5, R41.1, TP33.1, U9.34 (RXD0/IO3)
/MCU/U0TXD: J7.3, R20.2, R42.1, TP34.1
/SEQUENCER_UI/MCP_RST: R25.2; also elsewhere on the board
/SYNTH_CV/SPI_MOSI: R21.2, TP29.1; also elsewhere on the board
/SYNTH_CV/SPI_SCK: R22.2, TP30.1; also elsewhere on the board
GND: C31.2, C32.2, C33.2, C34.2, C35.2, C36.2, C37.2, C75.1, J7.4, R30.1, R32.1, R34.1, R36.2, R179.1, SW4.2, SW5.2, U1.4 (VSS), U9.1 (GND), U9.15 (GND), U9.38 (GND), U9.39 (GND), U10.3 (GND), U10.29 (GND), U17.4 (VSS); also elsewhere on the board
unnamed: J7.2, R207.2
unnamed: Q2.1 (B), R43.2
unnamed: Q2.3 (C), R45.2
unnamed: Q3.1 (B), R44.2
unnamed: Q3.3 (C), R46.2
unnamed: R19.2, R191.2, SW5.1
unnamed: R21.1, U9.16 (IO13)
unnamed: R22.1, U9.13 (IO14)
unnamed: R23.1, U9.23 (IO15)
unnamed: R24.1, U9.28 (IO17)
unnamed: R25.1, U9.30 (IO18)
unnamed: R206.1, U9.31 (IO19)
unnamed: R27.1, U9.33 (IO21)
unnamed: R28.1, U9.36 (IO22)
unnamed: R26.1, U9.11 (IO26)
unnamed: R20.1, U9.35 (TXD0/IO1)
unnamed: R42.2, U10.25 (RXD)
unnamed: R41.2, U10.26 (TXD)
unnamed: C35.1, R35.2, R36.1, U10.8 (VBUS)
unnamed: R40.1, U10.9 (~RST)
unnamed: R179.2, U10.11 (~SUSPEND)
VIN_5V: R35.1; also elsewhere on the board

Notes on the sheet:
ADDRESS: SHT40-A, (0x44)
USB to UART
Placed close to Exponential Converter (OSC1)
Placed close to Exponential Converter (OSC2)
(ANALOG)
(DAC)
ADDRESS: SHT40-B, (0x45)
Digital Temperature Sensor
MCU

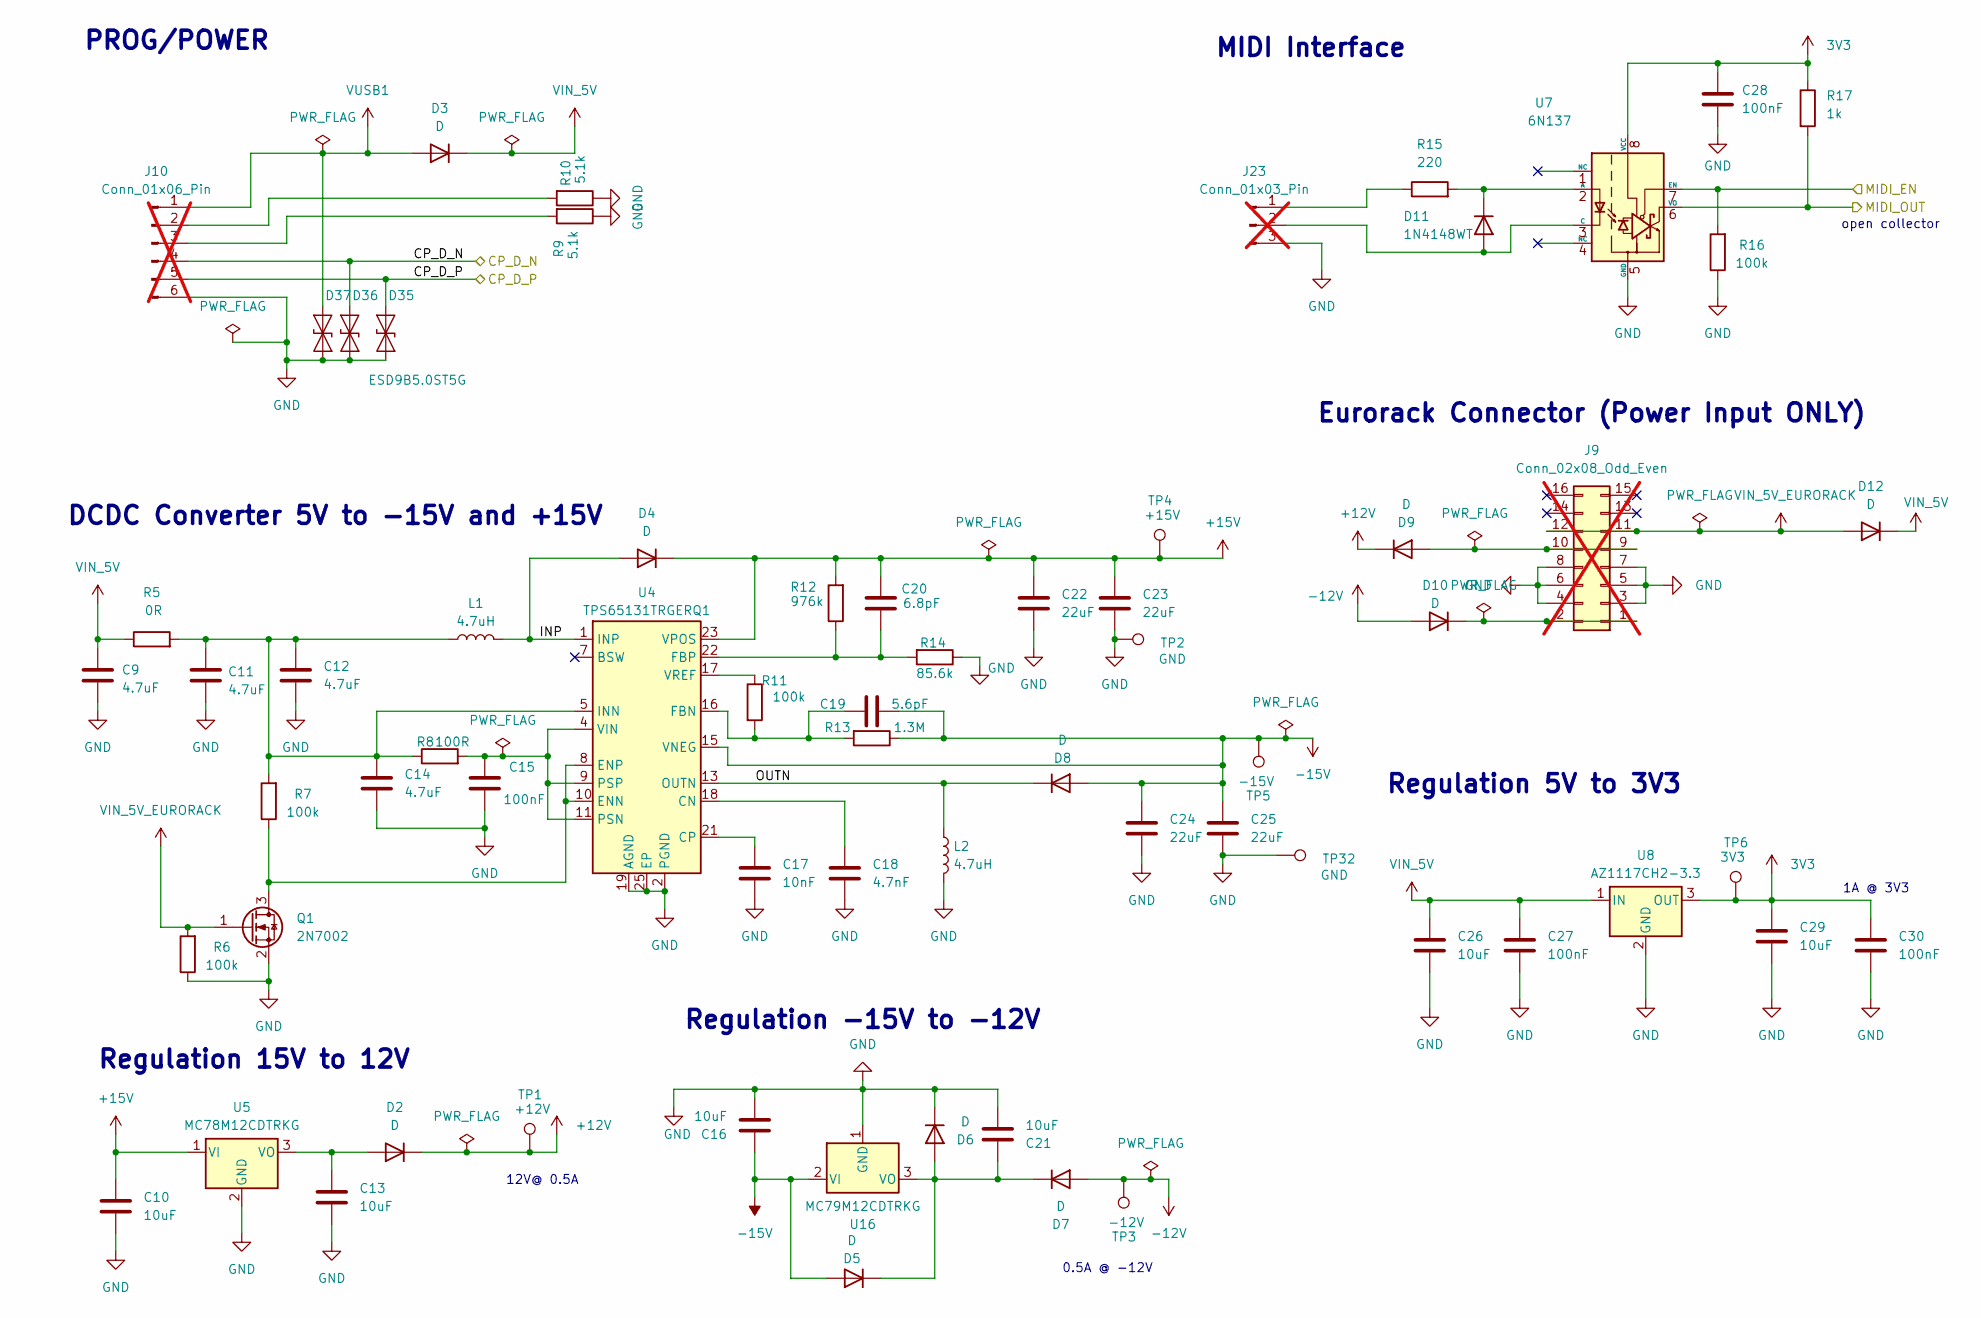
[picture p3: schematic powersupply.kicad_sch]

Parts:
C9, C11, C12, C14: 4.7uF; C_0805_2012Metric; Manufacturer PartNumer GRM219R61E475MA73D
C10, C13, C16, C21, C26, C29: 10uF; C_0805_2012Metric; Manufacturer PartNumer GRM21BR61E106KA73K
C15, C27, C28, C30: 100nF; C_0402_1005Metric; Manufacturer PartNumer GRM155R71E104KE14J
C17: 10nF; C_0402_1005Metric; Manufacturer PartNumer GRM155R71E103KA01D
C18: 4.7nF; C_0402_1005Metric; Manufacturer PartNumer GRM155R71E472KA01J
C19: 5.6pF; C_0402_1005Metric; Manufacturer PartNumer GJM1555C1H5R6BB01J
C20: 6.8pF; C_0402_1005Metric; Manufacturer PartNumer GJM1555C1H6R8DB01D
C22, C23, C24, C25: 22uF; C_1210_3225Metric; Manufacturer PartNumer CL32A226KAJNNNE
D2, D3, D4, D5, D6, D7, D8, D9, D10, D12: D; D_Powermite_AK; Manufacturer PartNumer MBRM120LT1G
D11: 1N4148WT; D_SOD-523; Manufacturer PartNumer 1N4148WT
D35, D36, D37: ESD9B5.0ST5G; D_SOD-923; Manufacturer PartNumer ESD9B5.0ST5G
J9: Conn_02x08_Odd_Even; PinHeader_2x08_P2.54mm_Vertical; Manufacturer PartNumer TST-108-02-T-D; not fitted
J10: Conn_01x06_Pin; PinHeader_1x06_P2.54mm_Vertical; not fitted
J23: Conn_01x03_Pin; PinHeader_1x03_P2.54mm_Vertical; not fitted
L1, L2: 4.7uH; L_TDK_SLF6028; Manufacturer PartNumer SLF6028T-4R7M1R6-PF
Q1: 2N7002; SOT-23; Manufacturer PartNumer 2N7002
R5: 0R; R_1210_3225Metric; Manufacturer PartNumer RC0402FR-070RL
R6, R7, R11, R16: 100k; R_0402_1005Metric; Manufacturer PartNumer RT0402FRE07100KL
R8: 100R; R_0402_1005Metric; Manufacturer PartNumer RT0402FRE07100RL
R9, R10: 5.1k; R_0402_1005Metric; Manufacturer PartNumer RT0402FRE075K1L
R12: 976k; R_0402_1005Metric; Manufacturer PartNumer RC0402FR-07976KL
R13: 1.3M; R_0402_1005Metric; Manufacturer PartNumer RC0402FR-071M3L
R14: 85.6k; R_0402_1005Metric; Manufacturer PartNumer RT0402BRE0785K6L
R15: 220; R_0402_1005Metric; Manufacturer PartNumer RT0402FRE07220RL
R17: 1k; R_0402_1005Metric; Manufacturer PartNumer RT0402FRE071KL
TP1: +12V; TestPoint_Pad_1.0x1.0mm
TP2, TP32: GND; TestPoint_Pad_1.0x1.0mm
TP3: -12V; TestPoint_Pad_1.0x1.0mm
TP4: +15V; TestPoint_Pad_1.0x1.0mm
TP5: -15V; TestPoint_Pad_1.0x1.0mm
TP6: 3V3; TestPoint_Pad_1.0x1.0mm
U4: TPS65131TRGERQ1; VQFN-24-1EP_4x4mm_P0.5mm_EP2.45x2.45mm_ThermalVias; Manufacturer PartNumer TPS65131TRGERQ1
U5: MC78M12CDTRKG; TO-252-2; Manufacturer PartNumer MC78M12CDTRKG
U7: 6N137; DIP-8_W7.62mm; Manufacturer PartNumer 6N137-X007T
U8: AZ1117CH2-3.3; SOT-223-3_TabPin2; Manufacturer PartNumer AZ1117CH2-3.3TRG1
U16: MC79M12CDTRKG; TO-252-2; Manufacturer PartNumer MC79M12CDTRKG

Connections:
3V3: C28.1, C29.1, C30.1, R17.1, TP6.1, U7.8 (VCC), U8.3 (OUT); also elsewhere on the board
+12V: D2.1 (K), D9.1 (K), TP1.1; also elsewhere on the board
+15V: C10.1, C20.1, C22.1, C23.1, D4.1 (K), R12.2, TP4.1, U4.23 (VPOS), U5.1 (VI)
-12V: D7.2 (A), D10.2 (A), TP3.1; also elsewhere on the board
-15V: C16.1, C19.2, C24.1, C25.1, D5.2 (A), D8.2 (A), R13.1, TP5.1, U4.15 (VNEG), U16.2 (VI)
/MCU/CP_D_N: D36.2 (A2), J10.4; also elsewhere on the board
/MCU/CP_D_P: D35.2 (A2), J10.5; also elsewhere on the board
/MCU/ESP_GPIO16: R17.2, U7.6 (VO); also elsewhere on the board
/MCU/MIDI_EN: R16.2, U7.7 (EN); also elsewhere on the board
/POWER_AND_INPUTS/INP: D4.2 (A), L1.2, U4.1 (INP), U4.24 (INP)
/POWER_AND_INPUTS/OUTN: D8.1 (K), L2.1, U4.13 (OUTN), U4.14 (OUTN)
GND: C9.2, C10.2, C11.2, C12.2, C13.2, C14.2, C15.2, C16.2, C17.2, C18.2, C21.2, C22.2, C23.2, C24.2, C25.2, C26.2, C27.2, C28.2, C29.2, C30.2, D6.1 (K), D35.1 (A1), D36.1 (A1), D37.1 (A1), J9.3, J9.4, J9.5, J9.6, J9.7, J9.8, J10.6, J23.3, L2.2, Q1.2 (S), R6.1, R9.1, R10.1, R14.1, R16.1, TP2.1, TP32.1, U4.2 (PGND), U4.3 (PGND), U4.19 (AGND), U4.25 (EP), U5.2 (GND), U7.5 (GND), U8.2 (GND), U16.1 (GND); also elsewhere on the board
unnamed: C11.1, C12.1, C14.1, L1.1, R5.2, R7.2, R8.1, U4.5 (INN), U4.6 (INN)
unnamed: C13.1, D2.2 (A), U5.3 (VO)
unnamed: C21.1, D5.1 (K), D6.2 (A), D7.1 (K), U16.3 (VO)
unnamed: D9.2 (A), J9.9, J9.10
unnamed: D10.1 (K), J9.1, J9.2
unnamed: D11.2 (A), J23.2, U7.3 (C)
unnamed: D11.1 (K), R15.2, U7.2 (A)
unnamed: J10.2, R10.2
unnamed: J10.3, R9.2
unnamed: J23.1, R15.1
unnamed: Q1.3 (D), R7.1, U4.8 (ENP), U4.10 (ENN)
unnamed: C18.1, U4.18 (CN)
unnamed: C17.1, U4.21 (CP)
unnamed: C19.1, R11.2, R13.2, U4.16 (FBN)
unnamed: C20.2, R12.1, R14.2, U4.22 (FBP)
unnamed: C15.1, R8.2, U4.4 (VIN), U4.9 (PSP), U4.11 (PSN)
unnamed: R11.1, U4.17 (VREF)
VIN_5V: C9.1, C26.1, C27.1, D3.1 (K), D12.1 (K), R5.1, U8.1 (IN); also elsewhere on the board
VIN_5V_EURORACK: D12.2 (A), J9.11, J9.12, Q1.1 (G), R6.2
VUSB1: D3.2 (A), D37.2 (A2), J10.1

Notes on the sheet:
12V@ 0.5A
DCDC Converter 5V to -15V and +15V
0.5A @ -12V
Regulation -15V to -12V
MIDI Interface
Regulation 15V to 12V
1A @ 3V3
Eurorack Connector (Power Input ONLY)
Regulation 5V to 3V3
open collector
PROG/POWER

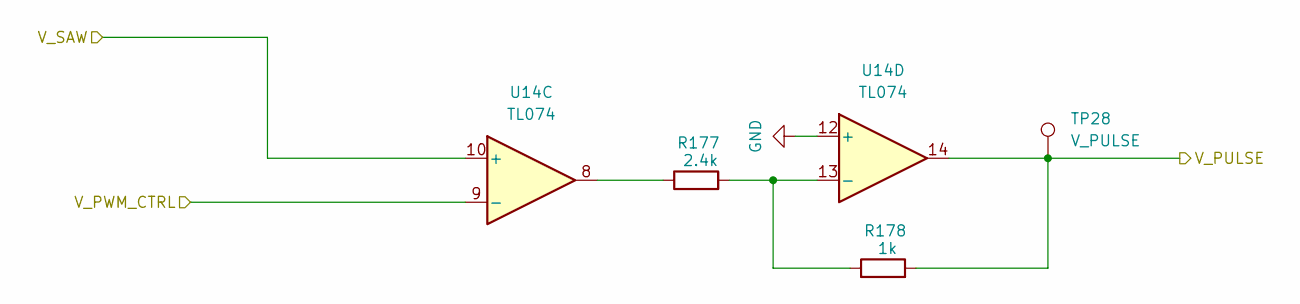
[picture p4: schematic saw_pulse.kicad_sch]

Parts:
R177: 2.4k; R_0402_1005Metric; Manufacturer PartNumer RT0402BRD072K4L
R178: 1k; R_0402_1005Metric; Manufacturer PartNumer RT0402FRE071KL
TP28: V_PULSE; TestPoint_Pad_1.0x1.0mm
U14: TL074; SOIC-14_3.9x8.7mm_P1.27mm; Manufacturer PartNumer TL074HIDR

Connections:
/SAW_PULSE_A/V_PULSE: R178.2, TP28.1, U14.14; also elsewhere on the board
/SAW_PULSE_A/V_PWM_CTRL: U14.9 (-); also elsewhere on the board
/SAW_PULSE_A/V_SAW: U14.10 (+); also elsewhere on the board
GND: U14.12 (+); also elsewhere on the board
unnamed: R177.1, U14.8
unnamed: R177.2, R178.1, U14.13 (-)

Parts of its further copies:
R107: 2.4k; R_0402_1005Metric; Manufacturer PartNumer RT0402BRD072K4L
R108: 1k; R_0402_1005Metric; Manufacturer PartNumer RT0402FRE071KL
TP18: V_PULSE; TestPoint_Pad_1.0x1.0mm
U24: TL074; SOIC-14_3.9x8.7mm_P1.27mm; Manufacturer PartNumer TL074HIDR

Connections of its further copies:
+12V: U24.4 (V+); also elsewhere on the board
-12V: U24.11 (V-); also elsewhere on the board
/SAW_PULSE_A/V_PWM_CTRL: U24.9 (-); also elsewhere on the board
/SAW_PULSE_B/V_PULSE: R108.2, TP18.1, U24.14; also elsewhere on the board
/SAW_PULSE_B/V_SAW: U24.10 (+); also elsewhere on the board
/SAW_TRIANG_B/V_TRIANGLE: U24.1; also elsewhere on the board
/TRIANG_SINE_B/V_SINE: U24.7; also elsewhere on the board
GND: U24.12 (+); also elsewhere on the board
unnamed 158: U24.5 (+); also elsewhere on the board
unnamed: R107.1, U24.8
unnamed 268: U24.3 (+); also elsewhere on the board
unnamed 269: U24.2 (-); also elsewhere on the board
unnamed 270: U24.6 (-); also elsewhere on the board
unnamed: R107.2, R108.1, U24.13 (-)

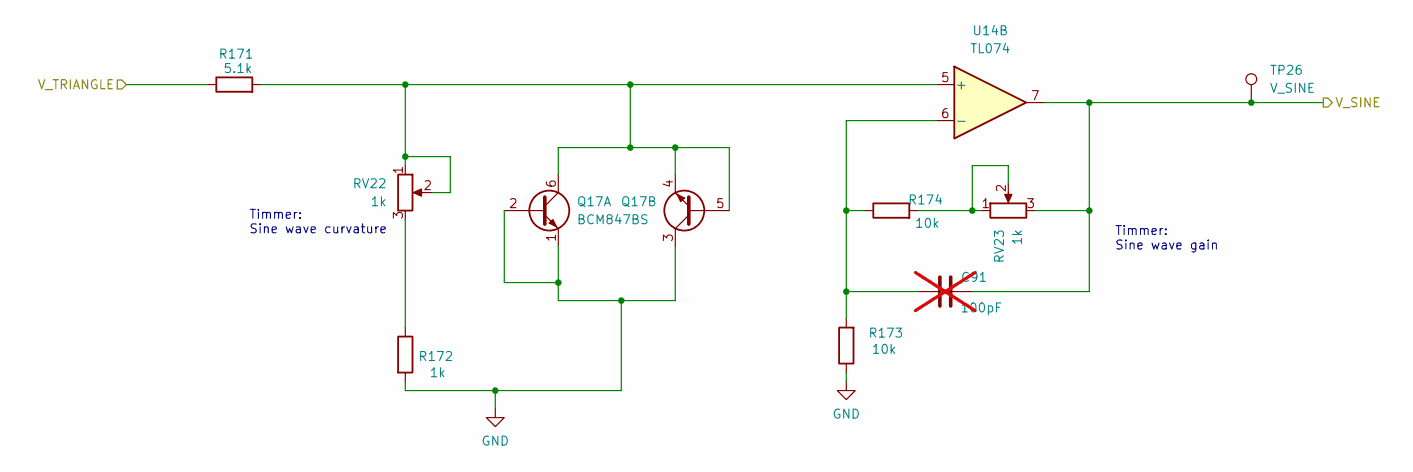
[picture p5: schematic triang_sine.kicad_sch]

Parts:
C91: 100pF; C_0402_1005Metric; Manufacturer PartNumer GCM1555C1H101FA16J; not fitted
Q17: BCM847BS; SOT-363_SC-70-6; Manufacturer PartNumer BCM847BS
R171: 5.1k; R_0402_1005Metric; Manufacturer PartNumer RT0402FRE075K1L
R172: 1k; R_0402_1005Metric; Manufacturer PartNumer RT0402FRE071KL
R173, R174: 10k; R_0402_1005Metric; Manufacturer PartNumer RT0402FRE0710KL
RV22, RV23: 1k; Potentiometer_Bourns_3296W_Vertical; Manufacturer PartNumer 3296W-102-LF
TP26: V_SINE; TestPoint_Pad_1.0x1.0mm
U14: TL074; SOIC-14_3.9x8.7mm_P1.27mm; Manufacturer PartNumer TL074HIDR

Connections:
/SAW_TRIANG_A/V_TRIANGLE: R171.1; also elsewhere on the board
/TRIANG_SINE_A/V_SINE: C91.2, RV23.3, TP26.1, U14.7; also elsewhere on the board
GND: Q17.1 (E1), Q17.2 (B1), Q17.3 (C2), R172.2, R173.1; also elsewhere on the board
unnamed: Q17.4 (E2), Q17.5 (B2), Q17.6 (C1), R171.2, RV22.1, RV22.2, U14.5 (+)
unnamed: R172.1, RV22.3
unnamed: R174.2, RV23.1, RV23.2
unnamed: C91.1, R173.2, R174.1, U14.6 (-)

Parts of its further copies:
C66: 100pF; C_0402_1005Metric; Manufacturer PartNumer GCM1555C1H101FA16J; not fitted
Q11: BCM847BS; SOT-363_SC-70-6; Manufacturer PartNumer BCM847BS
R101: 5.1k; R_0402_1005Metric; Manufacturer PartNumer RT0402FRE075K1L
R102: 1k; R_0402_1005Metric; Manufacturer PartNumer RT0402FRE071KL
R103, R104: 10k; R_0402_1005Metric; Manufacturer PartNumer RT0402FRE0710KL
RV9, RV10: 1k; Potentiometer_Bourns_3296W_Vertical; Manufacturer PartNumer 3296W-102-LF
TP16: V_SINE; TestPoint_Pad_1.0x1.0mm
U24: TL074; SOIC-14_3.9x8.7mm_P1.27mm; Manufacturer PartNumer TL074HIDR

Connections of its further copies:
+12V: U24.4 (V+); also elsewhere on the board
-12V: U24.11 (V-); also elsewhere on the board
/SAW_PULSE_A/V_PWM_CTRL: U24.9 (-); also elsewhere on the board
/SAW_PULSE_B/V_PULSE: U24.14; also elsewhere on the board
/SAW_PULSE_B/V_SAW: U24.10 (+); also elsewhere on the board
/SAW_TRIANG_B/V_TRIANGLE: R101.1, U24.1; also elsewhere on the board
/TRIANG_SINE_B/V_SINE: C66.2, RV10.3, TP16.1, U24.7; also elsewhere on the board
GND: Q11.1 (E1), Q11.2 (B1), Q11.3 (C2), R102.2, R103.1, U24.12 (+); also elsewhere on the board
unnamed: Q11.4 (E2), Q11.5 (B2), Q11.6 (C1), R101.2, RV9.1, RV9.2, U24.5 (+)
unnamed: R102.1, RV9.3
unnamed: R104.2, RV10.1, RV10.2
unnamed 190: U24.8; also elsewhere on the board
unnamed 268: U24.3 (+); also elsewhere on the board
unnamed 269: U24.2 (-); also elsewhere on the board
unnamed: C66.1, R103.2, R104.1, U24.6 (-)
unnamed 271: U24.13 (-); also elsewhere on the board

Notes on the sheet:
Timmer: Sine wave gain
Timmer: Sine wave curvature

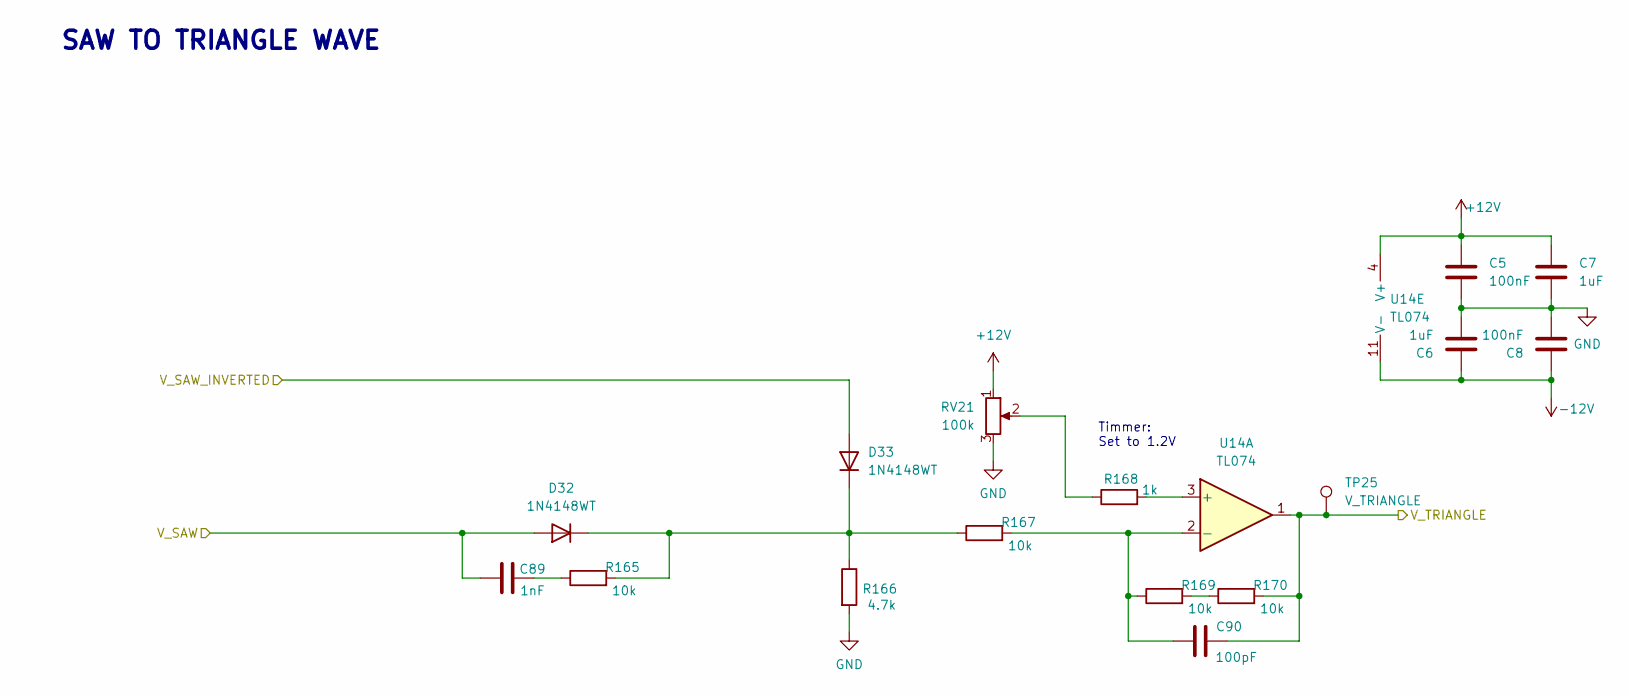
[picture p6: schematic saw_triang.kicad_sch]

Parts:
C5, C8: 100nF; C_0402_1005Metric; Manufacturer PartNumer GRM155R71E104KE14J
C6, C7: 1uF; C_0805_2012Metric; Manufacturer PartNumer GRM219R71E105MA88J
C89: 1nF; C_0402_1005Metric; Manufacturer PartNumer GRM155R71E103KA01J
C90: 100pF; C_0402_1005Metric; Manufacturer PartNumer GCM1555C1H101FA16J
D32, D33: 1N4148WT; D_SOD-523; Manufacturer PartNumer 1N4148WT
R165, R167, R169, R170: 10k; R_0402_1005Metric; Manufacturer PartNumer RT0402FRE0710KL
R166: 4.7k; R_0402_1005Metric; Manufacturer PartNumer RT0402FRE074K7L
R168: 1k; R_0402_1005Metric; Manufacturer PartNumer RT0402FRE071KL
RV21: 100k; Potentiometer_Bourns_3296W_Vertical; Manufacturer PartNumer 3296W-104-LF
TP25: V_TRIANGLE; TestPoint_Pad_1.0x1.0mm
U14: TL074; SOIC-14_3.9x8.7mm_P1.27mm; Manufacturer PartNumer TL074HIDR

Connections:
+12V: C5.1, C7.1, RV21.1, U14.4 (V+); also elsewhere on the board
-12V: C6.1, C8.1, U14.11 (V-); also elsewhere on the board
/SAW_PULSE_A/V_SAW: C89.1, D32.2 (A); also elsewhere on the board
/SAW_TRIANG_A/V_SAW_INVERTED: D33.2 (A); also elsewhere on the board
/SAW_TRIANG_A/V_TRIANGLE: C90.2, R170.2, TP25.1, U14.1; also elsewhere on the board
GND: C5.2, C6.2, C7.2, C8.2, R166.2, RV21.3; also elsewhere on the board
unnamed: C89.2, R165.1
unnamed: D32.1 (K), D33.1 (K), R165.2, R166.1, R167.1
unnamed: R168.1, RV21.2
unnamed: R169.2, R170.1
unnamed: R168.2, U14.3 (+)
unnamed: C90.1, R167.2, R169.1, U14.2 (-)

Parts of its further copies:
C1, C4: 100nF; C_0402_1005Metric; Manufacturer PartNumer GRM155R71E104KE14J
C2, C3: 1uF; C_0805_2012Metric; Manufacturer PartNumer GRM219R71E105MA88J
C64: 1nF; C_0402_1005Metric; Manufacturer PartNumer GRM155R71E103KA01J
C65: 100pF; C_0402_1005Metric; Manufacturer PartNumer GCM1555C1H101FA16J
D14, D15: 1N4148WT; D_SOD-523; Manufacturer PartNumer 1N4148WT
R95, R97, R99, R100: 10k; R_0402_1005Metric; Manufacturer PartNumer RT0402FRE0710KL
R96: 4.7k; R_0402_1005Metric; Manufacturer PartNumer RT0402FRE074K7L
R98: 1k; R_0402_1005Metric; Manufacturer PartNumer RT0402FRE071KL
RV8: 100k; Potentiometer_Bourns_3296W_Vertical; Manufacturer PartNumer 3296W-104-LF
TP15: V_TRIANGLE; TestPoint_Pad_1.0x1.0mm
U24: TL074; SOIC-14_3.9x8.7mm_P1.27mm; Manufacturer PartNumer TL074HIDR

Connections of its further copies:
+12V: C1.1, C3.1, RV8.1, U24.4 (V+); also elsewhere on the board
-12V: C2.1, C4.1, U24.11 (V-); also elsewhere on the board
/SAW_PULSE_A/V_PWM_CTRL: U24.9 (-); also elsewhere on the board
/SAW_PULSE_B/V_PULSE: U24.14; also elsewhere on the board
/SAW_PULSE_B/V_SAW: C64.1, D14.2 (A), U24.10 (+); also elsewhere on the board
/SAW_TRIANG_B/V_SAW_INVERTED: D15.2 (A); also elsewhere on the board
/SAW_TRIANG_B/V_TRIANGLE: C65.2, R100.2, TP15.1, U24.1; also elsewhere on the board
/TRIANG_SINE_B/V_SINE: U24.7; also elsewhere on the board
GND: C1.2, C2.2, C3.2, C4.2, R96.2, RV8.3, U24.12 (+); also elsewhere on the board
unnamed: C64.2, R95.1
unnamed: D14.1 (K), D15.1 (K), R95.2, R96.1, R97.1
unnamed 158: U24.5 (+); also elsewhere on the board
unnamed: R98.1, RV8.2
unnamed: R99.2, R100.1
unnamed 190: U24.8; also elsewhere on the board
unnamed: R98.2, U24.3 (+)
unnamed: C65.1, R97.2, R99.1, U24.2 (-)
unnamed 270: U24.6 (-); also elsewhere on the board
unnamed 271: U24.13 (-); also elsewhere on the board

Notes on the sheet:
Timmer: Set to 1.2V
SAW TO TRIANGLE WAVE
