FabioCL/analog_synth/hardware/kicad_project/hybrid_core_module/midi_vco_module/midi_vco_module.kicad_pcb

## KiCad design hardware/kicad_project/hybrid_core_module/midi_vco_module/midi_vco_module.kicad_pcb (continued)

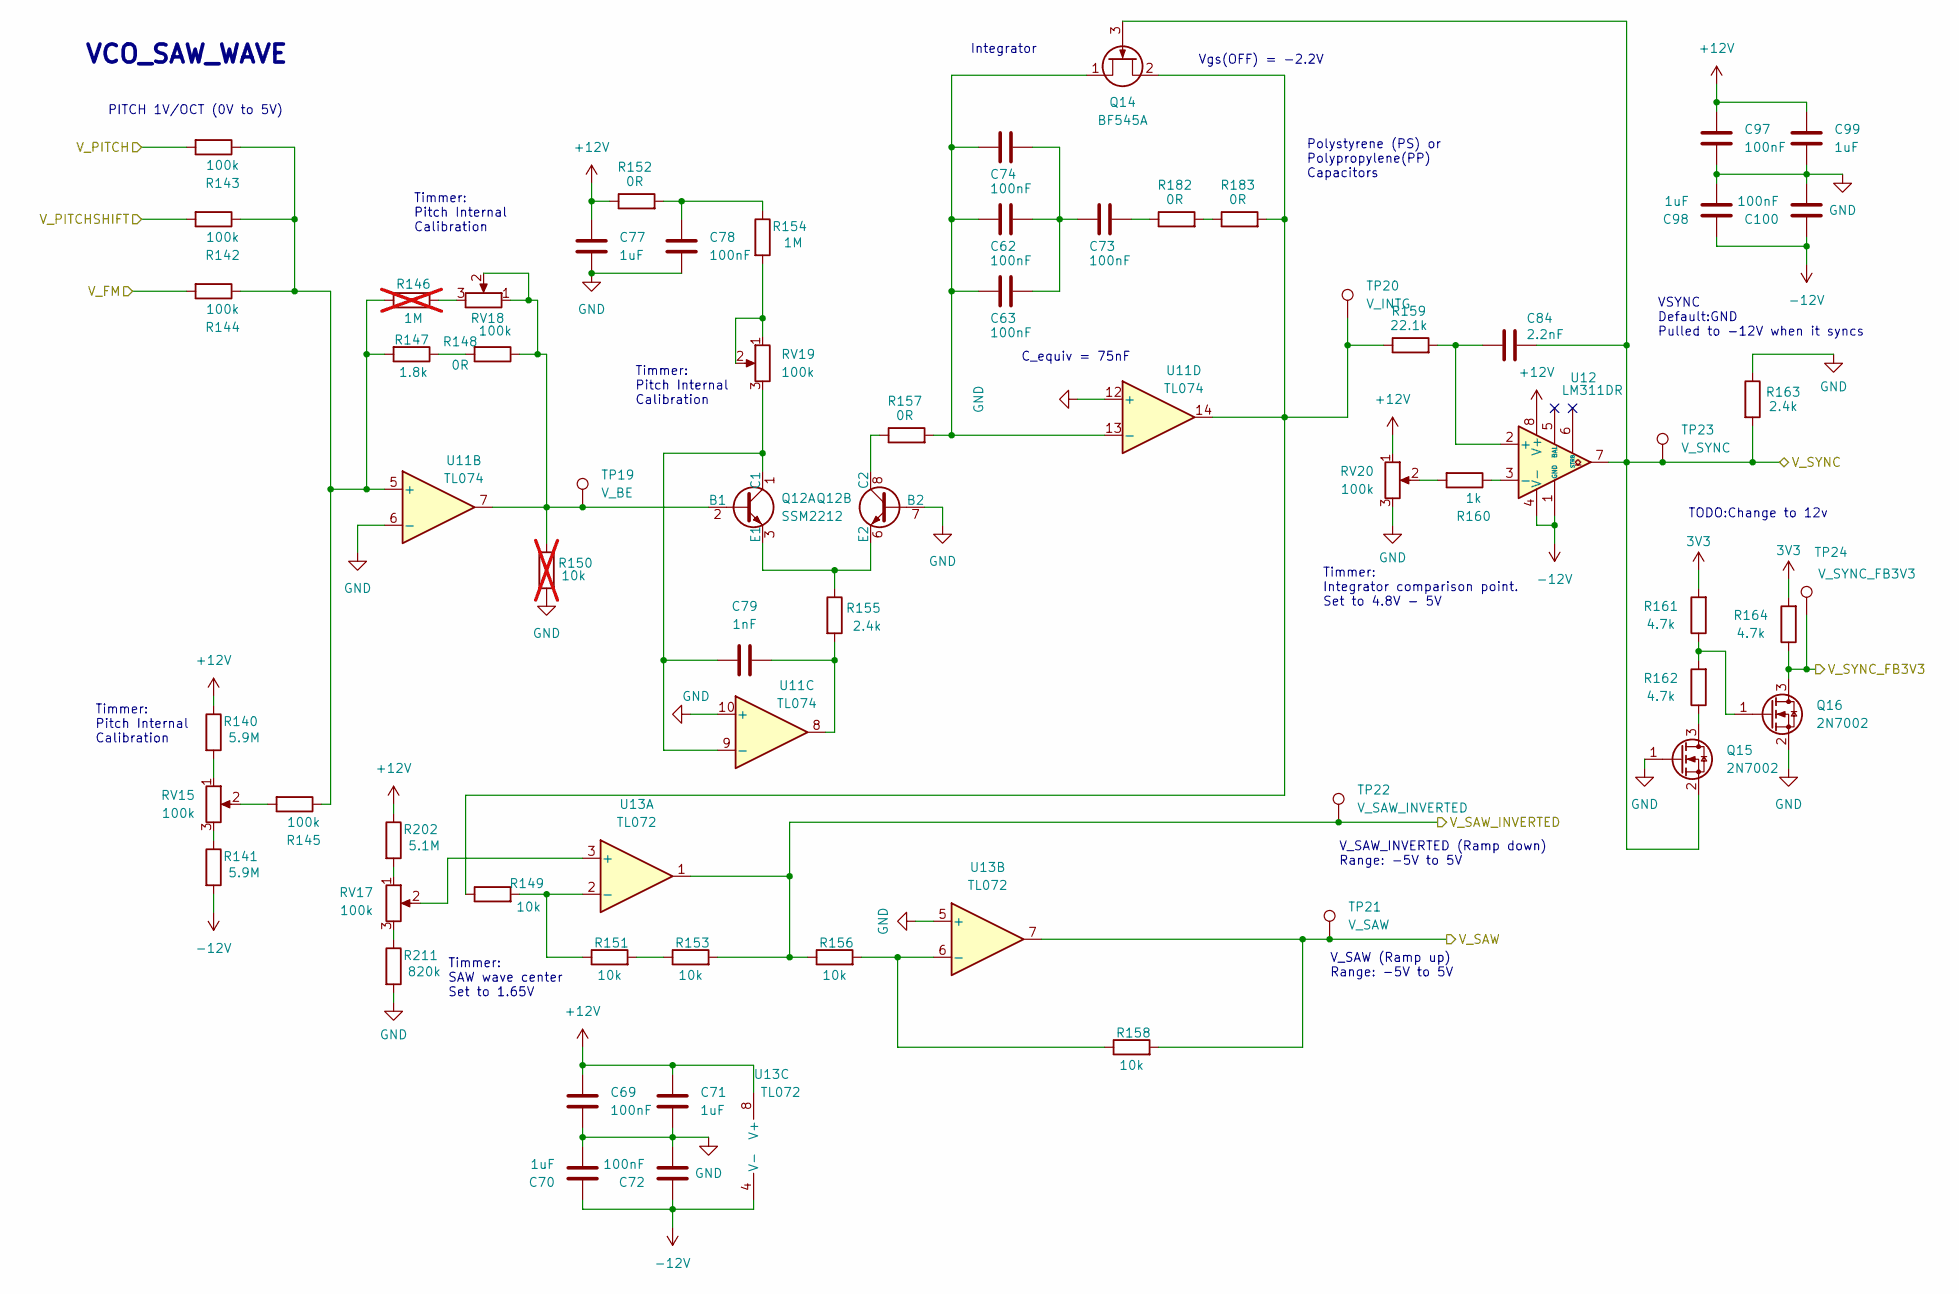
[picture p7: schematic osc1.kicad_sch]

Parts:
C62, C63, C73, C74: 100nF; C_1206_3216Metric; Manufacturer PartNumer GRT31C5C1H104FA02L
C69, C72, C78, C97, C100: 100nF; C_0402_1005Metric; Manufacturer PartNumer GRM155R71E104KE14J
C70, C71, C77, C98, C99: 1uF; C_0805_2012Metric; Manufacturer PartNumer GRM219R71E105MA88J
C79: 1nF; C_0402_1005Metric; Manufacturer PartNumer GRM155R71E103KA01J
C84: 2.2nF; C_0402_1005Metric; Manufacturer PartNumer GRM155R71H222KA01J
Q12: SSM2212; JEITA_SOIC-8_3.9x4.9mm_P1.27mm; Manufacturer PartNumer SSM2212RZ
Q14: BF545A; SOT-23; Manufacturer PartNumer MMBFJ108
Q15, Q16: 2N7002; SOT-23; Manufacturer PartNumer 2N7002
R140, R141: 5.9M; R_0402_1005Metric; Manufacturer PartNumer RC0402FR-075M9L
R142, R143, R144, R145: 100k; R_0402_1005Metric; Manufacturer PartNumer RT0402FRE07100KL
R146: 1M; R_0402_1005Metric; Manufacturer PartNumer RE0402BRE071ML; not fitted
R147: 1.8k; R_0402_1005Metric; Manufacturer PartNumer RT0402BRE071K8L
R148, R152, R157: 0R; R_0402_1005Metric; Manufacturer PartNumer RC0402FR-070RL
R149, R151, R153, R156, R158: 10k; R_0402_1005Metric; Manufacturer PartNumer RT0402FRE0710KL
R150: 10k; R_0402_1005Metric; Manufacturer PartNumer RT0402FRE0710KL; not fitted
R154: 1M; R_0402_1005Metric; Manufacturer PartNumer RE0402BRE071ML
R155, R163: 2.4k; R_0402_1005Metric; Manufacturer PartNumer RT0402BRD072K4L
R159: 22.1k; R_0402_1005Metric; Manufacturer PartNumer RT0402FRE0721KL
R160: 1k; R_0402_1005Metric; Manufacturer PartNumer RT0402FRE071KL
R161, R162, R164: 4.7k; R_0402_1005Metric; Manufacturer PartNumer RT0402FRE074K7L
R182, R183: 0R; R_1206_3216Metric; Manufacturer PartNumer RC0402FR-070RL
R202: 5.1M; R_0402_1005Metric; Manufacturer PartNumer RC0402FR-075M1L
R211: 820k; R_0402_1005Metric; Manufacturer PartNumer RC0402FR-07820KL
RV15, RV17, RV20: 100k; Potentiometer_Bourns_3296W_Vertical; Manufacturer PartNumer 3296W-104-LF
RV18, RV19: 100k; Potentiometer_Bourns_3296W_Vertical; Manufacturer PartNumer RT0402FRE07100KL
TP19: V_BE; TestPoint_Pad_1.0x1.0mm
TP20: V_INTG; TestPoint_Pad_1.0x1.0mm
TP21: V_SAW; TestPoint_Pad_1.0x1.0mm
TP22: V_SAW_INVERTED; TestPoint_Pad_1.0x1.0mm
TP23: V_SYNC; TestPoint_Pad_1.0x1.0mm
TP24: V_SYNC_FB3V3; TestPoint_Pad_1.0x1.0mm
U11: TL074; SOIC-14_3.9x8.7mm_P1.27mm; Manufacturer PartNumer TL074HIDR
U12: LM311DR; SOIC-8_5.3x6.2mm_P1.27mm; Manufacturer PartNumer LM311DR
U13: TL072; SOIC-8_5.3x6.2mm_P1.27mm; Manufacturer PartNumer TL072CDR

Connections:
3V3: R161.2, R164.2; also elsewhere on the board
+12V: C69.1, C71.1, C77.1, C97.1, C99.1, R140.1, R152.1, R202.1, RV20.1, U12.8 (V+), U13.8 (V+); also elsewhere on the board
-12V: C70.1, C72.1, C98.1, C100.1, R141.2, U12.1 (GND), U12.4 (V-), U13.4 (V-); also elsewhere on the board
/MCU/OSC1_FB: Q16.3 (D), R164.1, TP24.1; also elsewhere on the board
/SAW_PULSE_A/V_SAW: R158.2, TP21.1, U13.7; also elsewhere on the board
/SAW_TRIANG_A/V_SAW_INVERTED: R153.2, R156.1, TP22.1, U13.1; also elsewhere on the board
/SYNTH_CV/CTRL_PITCH_OSC1: R143.2; also elsewhere on the board
/VCO_SAW_A/V_FM: R144.2; also elsewhere on the board
/VCO_SAW_A/V_PITCHSHIFT: R142.2; also elsewhere on the board
/VCO_SAW_A/V_SYNC: C84.1, Q14.3 (G), Q15.2 (S), R163.2, TP23.1, U12.7; also elsewhere on the board
GND: C69.2, C70.2, C71.2, C72.2, C77.2, C78.2, C97.2, C98.2, C99.2, C100.2, Q12.7 (B2), Q15.1 (G), Q16.2 (S), R150.2, R163.1, R211.2, RV20.3, U11.6 (-), U11.10 (+), U11.12 (+), U13.5 (+); also elsewhere on the board
unnamed: C62.1, C63.1, C73.2, C74.1
unnamed: C73.1, R182.1
unnamed: C78.1, R152.2, R154.1
unnamed: C79.2, R155.2, U11.8
unnamed: Q12.2 (B1), R148.1, R150.1, RV18.1, RV18.2, TP19.1, U11.7
unnamed: C79.1, Q12.1 (C1), RV19.3, U11.9 (-)
unnamed: Q12.3 (E1), Q12.6 (E2), R155.1
unnamed: Q12.8 (C2), R157.1
unnamed: Q14.2 (D), R149.1, R159.1, R183.2, TP20.1, U11.14
unnamed: C62.2, C63.2, C74.2, Q14.1 (S), R157.2, U11.13 (-)
unnamed: Q15.3 (D), R162.1
unnamed: Q16.1 (G), R161.1, R162.2
unnamed: R140.2, RV15.1
unnamed: R141.1, RV15.3
unnamed: R145.2, RV15.2
unnamed: R146.1, RV18.3
unnamed: R147.1, R148.2
unnamed: R151.2, R153.1
unnamed: R154.2, RV19.1, RV19.2
unnamed: R160.2, RV20.2
unnamed: R182.2, R183.1
unnamed: R202.2, RV17.1
unnamed: R211.1, RV17.3
unnamed: R142.1, R143.1, R144.1, R145.1, R146.2, R147.2, U11.5 (+)
unnamed: C84.2, R159.2, U12.2 (+)
unnamed: R160.1, U12.3 (-)
unnamed: RV17.2, U13.3 (+)
unnamed: R149.2, R151.1, U13.2 (-)
unnamed: R156.2, R158.1, U13.6 (-)

Parts of its further copies:
C44, C47, C53, C101, C104: 100nF; C_0402_1005Metric; Manufacturer PartNumer GRM155R71E104KE14J
C45, C46, C52, C102, C103: 1uF; C_0805_2012Metric; Manufacturer PartNumer GRM219R71E105MA88J
C54: 1nF; C_0402_1005Metric; Manufacturer PartNumer GRM155R71E103KA01J
C55, C56, C57, C58: 100nF; C_1206_3216Metric; Manufacturer PartNumer GRT31C5C1H104FA02L
C59: 2.2nF; C_0402_1005Metric; Manufacturer PartNumer GRM155R71H222KA01J
Q6: SSM2212; JEITA_SOIC-8_3.9x4.9mm_P1.27mm; Manufacturer PartNumer SSM2212RZ
Q8: BF545A; SOT-23; Manufacturer PartNumer MMBFJ108
Q9, Q10: 2N7002; SOT-23; Manufacturer PartNumer 2N7002
R70, R71: 5.9M; R_0402_1005Metric; Manufacturer PartNumer RC0402FR-075M9L
R72, R73, R74, R75: 100k; R_0402_1005Metric; Manufacturer PartNumer RT0402FRE07100KL
R76: 1M; R_0402_1005Metric; Manufacturer PartNumer RE0402BRE071ML; not fitted
R77: 1.8k; R_0402_1005Metric; Manufacturer PartNumer RT0402BRE071K8L
R78, R82, R87: 0R; R_0402_1005Metric; Manufacturer PartNumer RC0402FR-070RL
R79, R81, R83, R86, R88: 10k; R_0402_1005Metric; Manufacturer PartNumer RT0402FRE0710KL
R80: 10k; R_0402_1005Metric; Manufacturer PartNumer RT0402FRE0710KL; not fitted
R84: 1M; R_0402_1005Metric; Manufacturer PartNumer RE0402BRE071ML
R85, R93: 2.4k; R_0402_1005Metric; Manufacturer PartNumer RT0402BRD072K4L
R89: 22.1k; R_0402_1005Metric; Manufacturer PartNumer RT0402FRE0721KL
R90: 1k; R_0402_1005Metric; Manufacturer PartNumer RT0402FRE071KL
R91, R92, R94: 4.7k; R_0402_1005Metric; Manufacturer PartNumer RT0402FRE074K7L
R180, R181: 0R; R_1206_3216Metric; Manufacturer PartNumer RC0402FR-070RL
R205: 5.1M; R_0402_1005Metric; Manufacturer PartNumer RC0402FR-075M1L
R212: 820k; R_0402_1005Metric; Manufacturer PartNumer RC0402FR-07820KL
RV2, RV4, RV7: 100k; Potentiometer_Bourns_3296W_Vertical; Manufacturer PartNumer 3296W-104-LF
RV5, RV6: 100k; Potentiometer_Bourns_3296W_Vertical; Manufacturer PartNumer RT0402FRE07100KL
TP9: V_BE; TestPoint_Pad_1.0x1.0mm
TP10: V_INTG; TestPoint_Pad_1.0x1.0mm
TP11: V_SAW; TestPoint_Pad_1.0x1.0mm
TP12: V_SAW_INVERTED; TestPoint_Pad_1.0x1.0mm
TP13: V_SYNC; TestPoint_Pad_1.0x1.0mm
TP14: V_SYNC_FB3V3; TestPoint_Pad_1.0x1.0mm
U22: LM311DR; SOIC-8_5.3x6.2mm_P1.27mm; Manufacturer PartNumer LM311DR
U23: TL072; SOIC-8_5.3x6.2mm_P1.27mm; Manufacturer PartNumer TL072CDR

Connections of its further copies:
3V3: R91.2, R94.2; also elsewhere on the board
+12V: C44.1, C46.1, C52.1, C101.1, C103.1, R70.1, R82.1, R205.1, RV7.1, U22.8 (V+), U23.8 (V+); also elsewhere on the board
-12V: C45.1, C47.1, C102.1, C104.1, R71.2, U22.1 (GND), U22.4 (V-), U23.4 (V-); also elsewhere on the board
/MCU/OSC2_FB: Q10.3 (D), R94.1, TP14.1; also elsewhere on the board
/SAW_PULSE_B/V_SAW: R88.2, TP11.1, U23.7; also elsewhere on the board
/SAW_TRIANG_B/V_SAW_INVERTED: R83.2, R86.1, TP12.1, U23.1; also elsewhere on the board
/SYNTH_CV/CTRL_PITCH_OSC2: R73.2; also elsewhere on the board
/VCO_SAW_A/V_FM: R74.2; also elsewhere on the board
/VCO_SAW_B/V_PITCHSHIFT: R72.2; also elsewhere on the board
/VCO_SAW_B/V_SYNC: C59.1, Q8.3 (G), Q9.2 (S), R93.2, TP13.1, U22.7; also elsewhere on the board
GND: C44.2, C45.2, C46.2, C47.2, C52.2, C53.2, C101.2, C102.2, C103.2, C104.2, Q6.7 (B2), Q9.1 (G), Q10.2 (S), R80.2, R93.1, R212.2, RV7.3, U23.5 (+); also elsewhere on the board
unnamed: C53.1, R82.2, R84.1
unnamed 97: C54.2, R85.2; also elsewhere on the board
unnamed: C55.1, C56.1, C57.2, C58.1
unnamed: C57.1, R180.1
unnamed 149: Q6.2 (B1), R78.1, R80.1, RV5.1, RV5.2, TP9.1; also elsewhere on the board
unnamed 150: C54.1, Q6.1 (C1), RV6.3; also elsewhere on the board
unnamed: Q6.3 (E1), Q6.6 (E2), R85.1
unnamed: Q6.8 (C2), R87.1
unnamed 154: Q8.2 (D), R79.1, R89.1, R181.2, TP10.1; also elsewhere on the board
unnamed 155: C55.2, C56.2, C58.2, Q8.1 (S), R87.2; also elsewhere on the board
unnamed: Q9.3 (D), R92.1
unnamed: Q10.1 (G), R91.1, R92.2
unnamed: R70.2, RV2.1
unnamed: R71.1, RV2.3
unnamed: R75.2, RV2.2
unnamed: R76.1, RV5.3
unnamed: R77.1, R78.2
unnamed: R81.2, R83.1
unnamed: R84.2, RV6.1, RV6.2
unnamed: R90.2, RV7.2
unnamed: R180.2, R181.1
unnamed: R205.2, RV4.1
unnamed: R212.1, RV4.3
unnamed 262: R72.1, R73.1, R74.1, R75.1, R76.2, R77.2; also elsewhere on the board
unnamed: C59.2, R89.2, U22.2 (+)
unnamed: R90.1, U22.3 (-)
unnamed: RV4.2, U23.3 (+)
unnamed: R79.2, R81.1, U23.2 (-)
unnamed: R86.2, R88.1, U23.6 (-)

Notes on the sheet:
Timmer: SAW wave center Set to 1.65V
TODO:Change to 12v
VSYNC Default:GND Pulled to -12V when it syncs
Polystyrene (PS) or Polypropylene(PP) Capacitors
Timmer: Pitch Internal Calibration
Integrator
C_equiv = 75nF
PITCH 1V/OCT (0V to 5V)
V_SAW_INVERTED (Ramp down) Range: -5V to 5V
Timmer: Integrator comparison point. Set to 4.8V - 5V
VCO_SAW_WAVE
V_SAW (Ramp up) Range: -5V to 5V
Vgs(OFF) = -2.2V

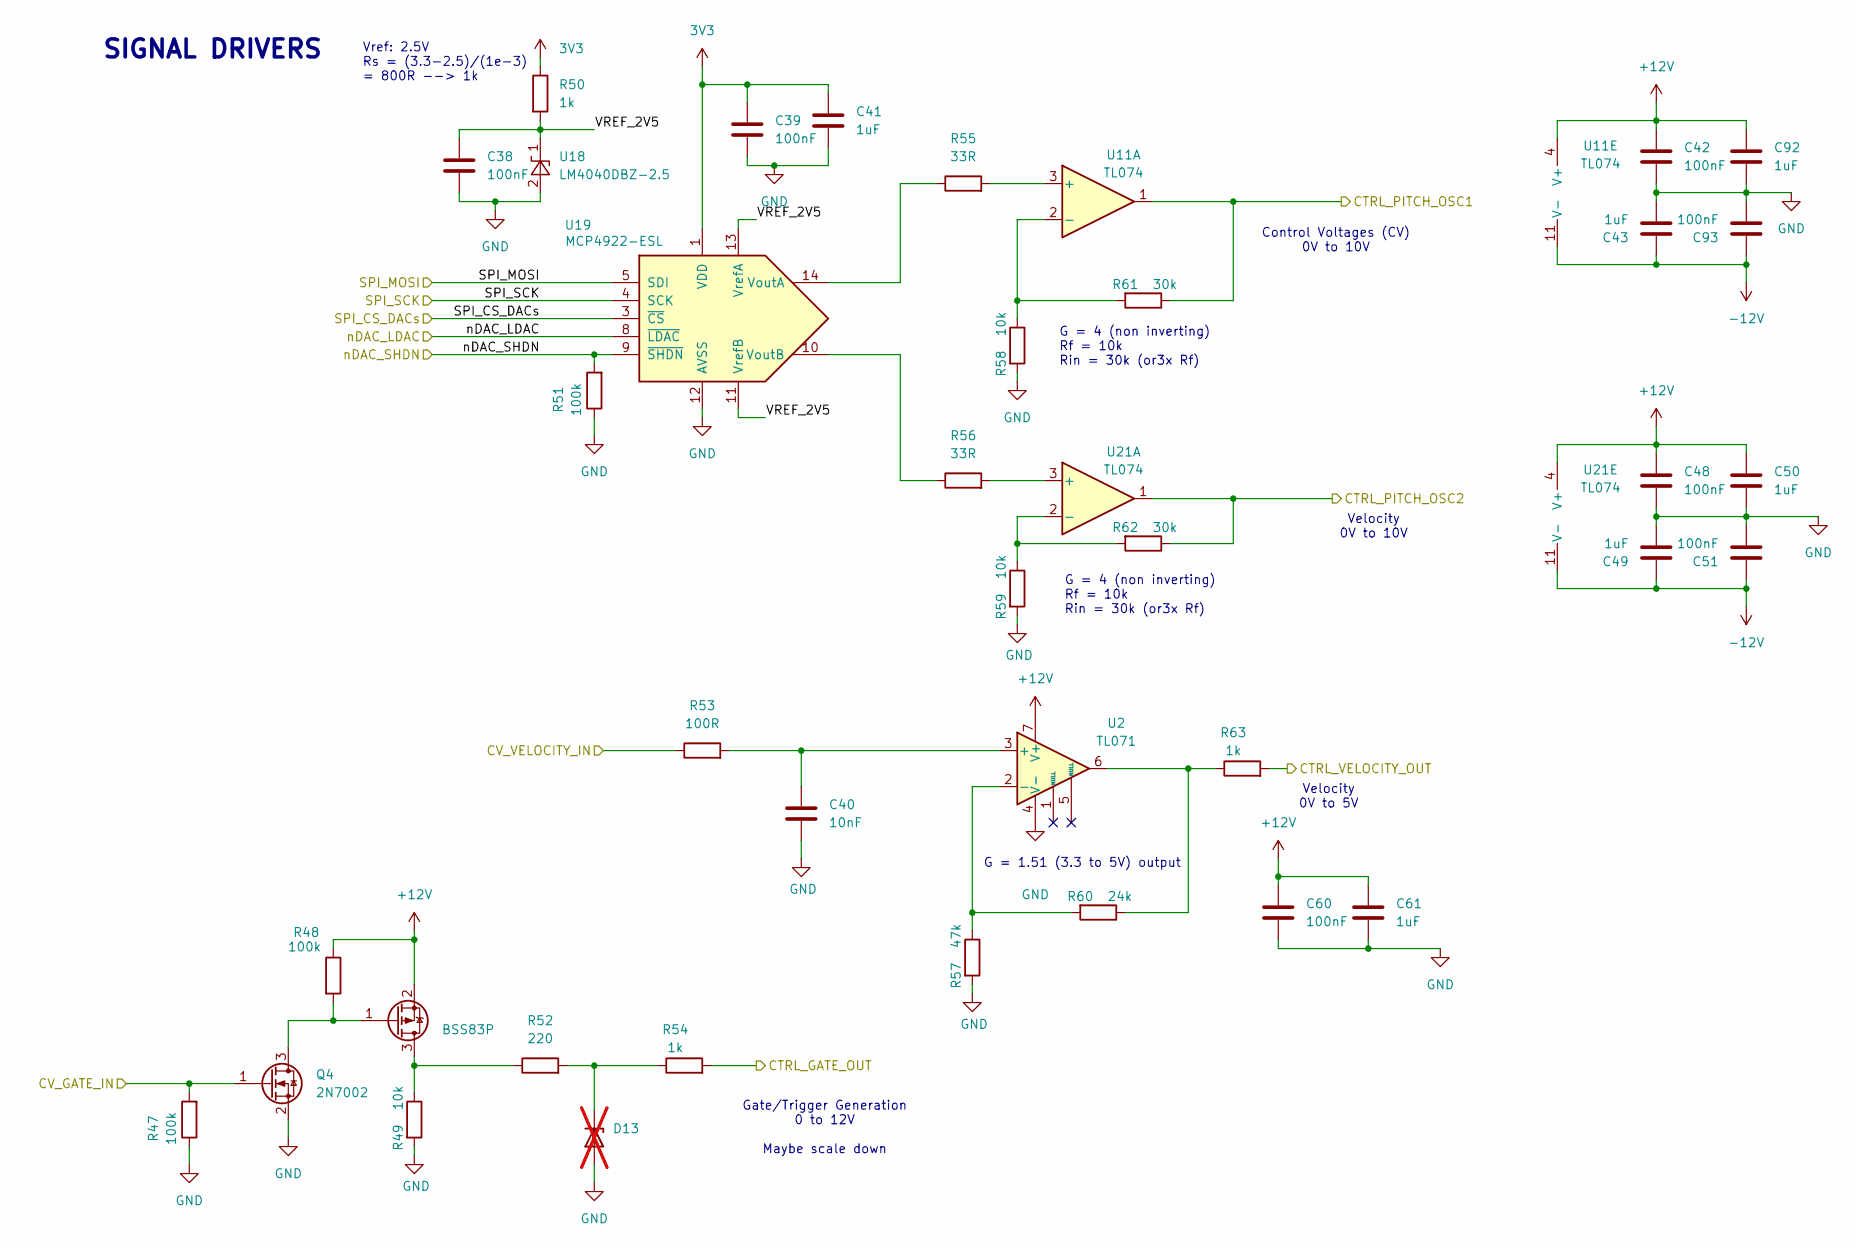
[picture p8: schematic signal_drivers.kicad_sch]

Parts:
C38, C39, C42, C48, C51, C60, C93: 100nF; C_0402_1005Metric; Manufacturer PartNumer GRM155R71E104KE14J
C40: 10nF; C_0402_1005Metric; Manufacturer PartNumer GRM155R71E103KA01D
C41, C43, C49, C50, C61, C92: 1uF; C_0805_2012Metric; Manufacturer PartNumer GRM219R71E105MA88J
D13: BZT52Bxx; D_SOD-123F; Manufacturer PartNumer BZT52-B10J; not fitted
Q4: 2N7002; SOT-23; Manufacturer PartNumer 2N7002
Q5: BSS83P; SOT-23; Manufacturer PartNumer BSS83PH6327XTSA1
R47, R48, R51: 100k; R_0402_1005Metric; Manufacturer PartNumer RT0402FRE07100KL
R49, R58, R59: 10k; R_0402_1005Metric; Manufacturer PartNumer RT0402FRE0710KL
R50, R54, R63: 1k; R_0402_1005Metric; Manufacturer PartNumer RT0402FRE071KL
R52: 220; R_0402_1005Metric; Manufacturer PartNumer RT0402FRE07220RL
R53: 100R; R_0402_1005Metric; Manufacturer PartNumer RT0402FRE07100RL
R55, R56: 33R; R_0402_1005Metric; Manufacturer PartNumer RT0402FRE0733RL
R57: 47k; R_0402_1005Metric; Manufacturer PartNumer RT0402FRE0747KL
R60: 24k; R_0402_1005Metric; Manufacturer PartNumer RT0402FRE0724KL
R61, R62: 30k; R_0402_1005Metric; Manufacturer PartNumer RT0402FRE0730KL
U2: TL071; SOIC-8_3.9x4.9mm_P1.27mm; Manufacturer PartNumer TL071CDR
U11, U21: TL074; SOIC-14_3.9x8.7mm_P1.27mm; Manufacturer PartNumer TL074HIDR
U18: LM4040DBZ-2.5; SOT-23; Manufacturer PartNumer LM4040QAIM3-2.5/NOPB
U19: MCP4922-ESL; SOIC-14_3.9x8.7mm_P1.27mm; Manufacturer PartNumer MCP4922-E/SL

Connections:
3V3: C39.1, C41.1, R50.1, U19.1 (VDD); also elsewhere on the board
+12V: C42.1, C48.1, C50.1, C60.1, C61.1, C92.1, Q5.2 (S), R48.1, U2.7 (V+), U11.4 (V+), U21.4 (V+); also elsewhere on the board
-12V: C43.1, C49.1, C51.1, C93.1, U11.11 (V-), U21.11 (V-); also elsewhere on the board
/MCU/CV_VELOCITY_DAC: R53.1; also elsewhere on the board
/MCU/ESP_GPIO04: R51.2, U19.9 (~SHDN); also elsewhere on the board
/MCU/ESP_GPIO05: U19.8 (~LDAC); also elsewhere on the board
/MCU/ESP_GPIO12: Q4.1 (G), R47.2; also elsewhere on the board
/MCU/ESP_GPIO15: U19.3 (~CS); also elsewhere on the board
/SYNTH_CV/CTRL_GATE_OUT: R54.2; also elsewhere on the board
/SYNTH_CV/CTRL_PITCH_OSC1: R61.1, U11.1; also elsewhere on the board
/SYNTH_CV/CTRL_PITCH_OSC2: R62.1, U21.1; also elsewhere on the board
/SYNTH_CV/CTRL_VELOCITY_OUT: R63.2; also elsewhere on the board
/SYNTH_CV/SPI_MOSI: U19.5 (SDI); also elsewhere on the board
/SYNTH_CV/SPI_SCK: U19.4 (SCK); also elsewhere on the board
/SYNTH_CV/VREF_2V5: C38.1, R50.2, U18.1 (K), U19.11 (VrefB), U19.13 (VrefA)
GND: C38.2, C39.2, C40.2, C41.2, C42.2, C43.2, C48.2, C49.2, C50.2, C51.2, C60.2, C61.2, C92.2, C93.2, D13.2 (A), Q4.2 (S), R47.1, R49.2, R51.1, R57.2, R58.2, R59.2, U2.4 (V-), U18.2 (A), U19.12 (AVSS); also elsewhere on the board
unnamed: D13.1 (K), R52.2, R54.1
unnamed: Q4.3 (D), Q5.1 (G), R48.2
unnamed: Q5.3 (D), R49.1, R52.1
unnamed: R60.1, R63.1, U2.6
unnamed: C40.1, R53.2, U2.3 (+)
unnamed: R57.1, R60.2, U2.2 (-)
unnamed: R55.2, U11.3 (+)
unnamed: R58.1, R61.2, U11.2 (-)
unnamed: R55.1, U19.14 (VoutA)
unnamed: R56.1, U19.10 (VoutB)
unnamed: R56.2, U21.3 (+)
unnamed: R59.1, R62.2, U21.2 (-)

Notes on the sheet:
Velocity 0V to 5V
G = 4 (non inverting) Rf = 10k Rin = 30k (or3x Rf)
G = 1.51 (3.3 to 5V) output
Gate/Trigger Generation 0 to 12V Maybe scale down
Control Voltages (CV) 0V to 10V
Velocity 0V to 10V
Vref: 2.5V Rs = (3.3-2.5)/(1e-3) = 800R --> 1k
SIGNAL DRIVERS

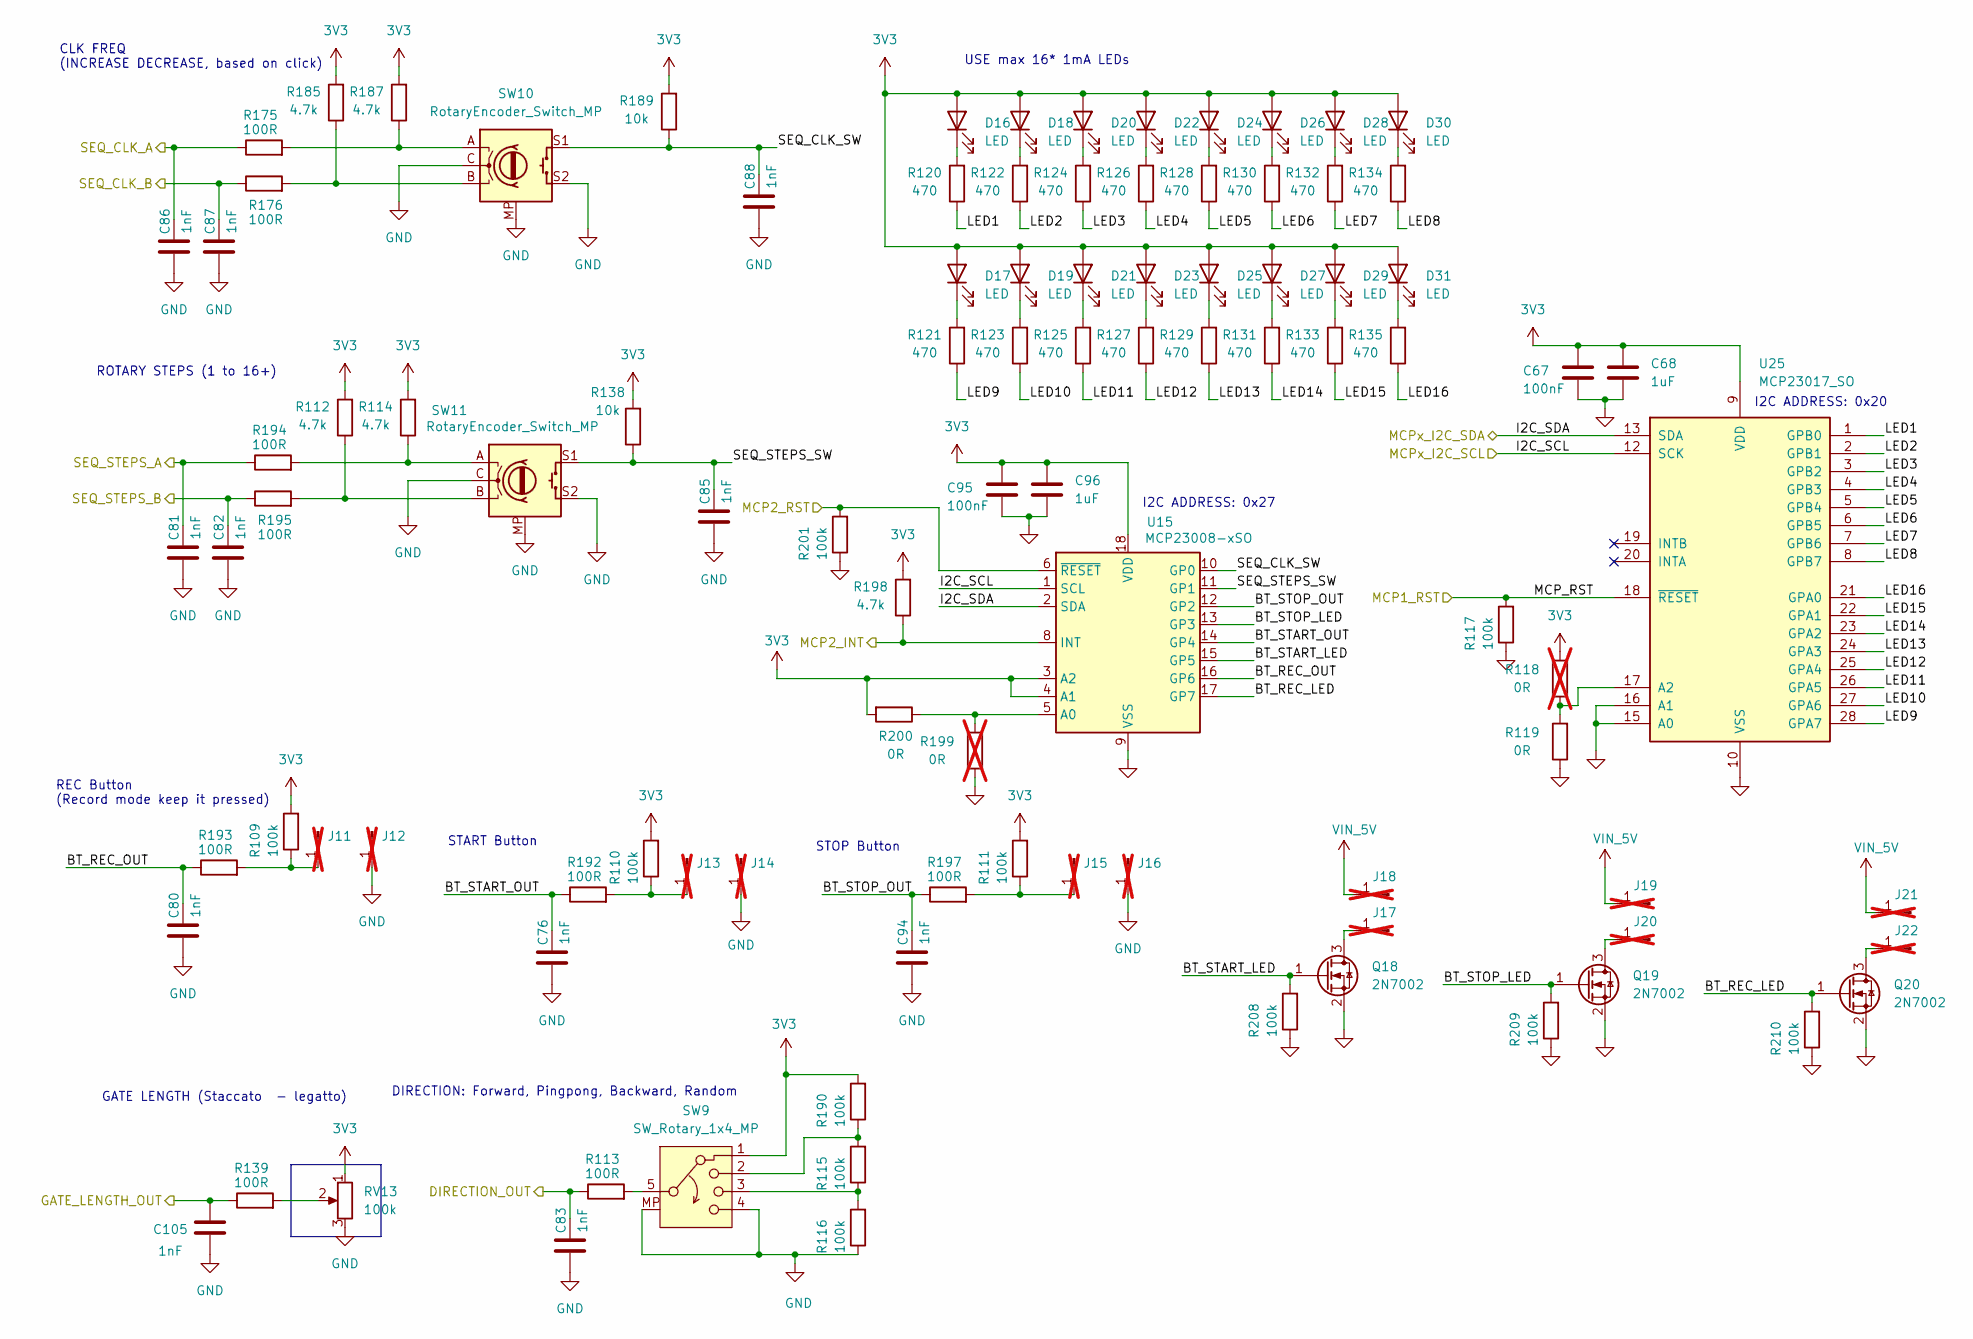
[picture p9: schematic sequencer_ui.kicad_sch]

Parts:
C67, C95: 100nF; C_0402_1005Metric; Manufacturer PartNumer GRM155R71E104KE14J
C68, C96: 1uF; C_0805_2012Metric; Manufacturer PartNumer GRM219R71E105MA88J
C76, C80, C81, C82, C83, C85, C86, C87, C88, C94, C105: 1nF; C_0402_1005Metric; Manufacturer PartNumer GRM155R71E103KA01J
D16, D17, D18, D19, D20, D21, D22, D23, D24, D25, D26, D27, D28, D29, D30, D31: LED; LED_D3.0mm_Clear; Manufacturer PartNumer ORANGE LED 3MM
J11, J12, J13, J14, J15, J16, J17, J18, J19, J20, J21, J22: Conn_01x01_Pin; PinHeader_1x01_P1.00mm_Vertical; not fitted
Q18, Q19, Q20: 2N7002; SOT-23; Manufacturer PartNumer 2N7002
R109, R110, R111, R115, R116, R117, R190, R201, R208, R209, R210: 100k; R_0402_1005Metric; Manufacturer PartNumer RT0402FRE07100KL
R112, R114, R185, R187, R198: 4.7k; R_0402_1005Metric; Manufacturer PartNumer RT0402FRE074K7L
R113, R139, R175, R176, R192, R193, R194, R195, R197: 100R; R_0402_1005Metric; Manufacturer PartNumer RT0402FRE07100RL
R118, R199: 0R; R_0402_1005Metric; Manufacturer PartNumer RC0402FR-070RL; not fitted
R119, R200: 0R; R_0402_1005Metric; Manufacturer PartNumer RC0402FR-070RL
R120, R121, R122, R123, R124, R125, R126, R127, R128, R129, R130, R131, R132, R133, R134, R135: 470; R_0402_1005Metric; Manufacturer PartNumer RT0402FRE07470RL
R138, R189: 10k; R_0402_1005Metric; Manufacturer PartNumer RT0402FRE0710KL
RV13: 100k; Potentiometer_RV09_Single_Vertical; Manufacturer PartNumer 3296W-104-LF
SW9: SW_Rotary_1x4_MP; SR16 Rotary Band Switch; Manufacturer PartNumer SR16
SW10, SW11: RotaryEncoder_Switch_MP; RotaryEncoder_Alps_EC11E-Switch_Vertical_H20mm_CircularMoun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
U15: MCP23008-xSO; SOIC-18W_7.5x11.6mm_P1.27mm; Manufacturer PartNumer MCP23008T-E/SO
U25: MCP23017_SO; SOIC-28W_7.5x17.9mm_P1.27mm; Manufacturer PartNumer MCP23017-E/SO

Connections:
3V3: C67.1, C68.1, C95.1, C96.1, D16.2 (A), D17.2 (A), D18.2 (A), D19.2 (A), D20.2 (A), D21.2 (A), D22.2 (A), D23.2 (A), D24.2 (A), D25.2 (A), D26.2 (A), D27.2 (A), D28.2 (A), D29.2 (A), D30.2 (A), D31.2 (A), R109.2, R110.2, R111.2, R112.2, R114.2, R118.2, R138.2, R185.2, R187.2, R189.2, R190.2, R198.2, R200.2, RV13.1, SW9.1, U15.3 (A2), U15.4 (A1), U15.18 (VDD), U25.9 (VDD); also elsewhere on the board
/MCU/I2C_SCL: U15.1 (SCL), U25.12 (SCK); also elsewhere on the board
/MCU/I2C_SDA: U15.2 (SDA), U25.13 (SDA); also elsewhere on the board
/MCU/MCP2_INT: R198.1, U15.8 (INT); also elsewhere on the board
/MCU/MCP2_RST: R201.2, U15.6 (~RESET); also elsewhere on the board
/MCU/SEQ_CLK_A: C86.2, R175.1; also elsewhere on the board
/MCU/SEQ_CLK_B: C87.2, R176.1; also elsewhere on the board
/MCU/SEQ_DIRECTION_IN: C83.2, R113.1; also elsewhere on the board
/MCU/SEQ_GATE_LENGTH_IN: C105.2, R139.1; also elsewhere on the board
/MCU/SEQ_STEPS_A: C81.2, R194.1; also elsewhere on the board
/MCU/SEQ_STEPS_B: C82.2, R195.1; also elsewhere on the board
/SEQUENCER_UI/BT_REC_LED: Q20.1 (G), R210.2, U15.17 (GP7)
/SEQUENCER_UI/BT_REC_OUT: C80.2, R193.1, U15.16 (GP6)
/SEQUENCER_UI/BT_START_LED: Q18.1 (G), R208.2, U15.15 (GP5)
/SEQUENCER_UI/BT_START_OUT: C76.2, R192.1, U15.14 (GP4)
/SEQUENCER_UI/BT_STOP_LED: Q19.1 (G), R209.2, U15.13 (GP3)
/SEQUENCER_UI/BT_STOP_OUT: C94.2, R197.1, U15.12 (GP2)
/SEQUENCER_UI/LED1: R120.1, U25.1 (GPB0)
/SEQUENCER_UI/LED2: R122.1, U25.2 (GPB1)
/SEQUENCER_UI/LED3: R124.1, U25.3 (GPB2)
/SEQUENCER_UI/LED4: R126.1, U25.4 (GPB3)
/SEQUENCER_UI/LED5: R128.1, U25.5 (GPB4)
/SEQUENCER_UI/LED6: R130.1, U25.6 (GPB5)
/SEQUENCER_UI/LED7: R132.1, U25.7 (GPB6)
/SEQUENCER_UI/LED8: R134.1, U25.8 (GPB7)
/SEQUENCER_UI/LED9: R121.1, U25.28 (GPA7)
/SEQUENCER_UI/LED10: R123.1, U25.27 (GPA6)
/SEQUENCER_UI/LED11: R125.1, U25.26 (GPA5)
/SEQUENCER_UI/LED12: R127.1, U25.25 (GPA4)
/SEQUENCER_UI/LED13: R129.1, U25.24 (GPA3)
/SEQUENCER_UI/LED14: R131.1, U25.23 (GPA2)
/SEQUENCER_UI/LED15: R133.1, U25.22 (GPA1)
/SEQUENCER_UI/LED16: R135.1, U25.21 (GPA0)
/SEQUENCER_UI/MCP_RST: R117.2, U25.18 (~RESET); also elsewhere on the board
/SEQUENCER_UI/SEQ_CLK_SW: C88.2, R189.1, SW10.S1, U15.10 (GP0)
/SEQUENCER_UI/SEQ_STEPS_SW: C85.2, R138.1, SW11.S1, U15.11 (GP1)
GND: C67.2, C68.2, C76.1, C80.1, C81.1, C82.1, C83.1, C85.1, C86.1, C87.1, C88.1, C94.1, C95.2, C96.2, C105.1, J12.1, J14.1, J16.1, Q18.2 (S), Q19.2 (S), Q20.2 (S), R116.1, R117.1, R119.1, R199.1, R201.1, R208.1, R209.1, R210.1, RV13.3, SW9.4, SW9.MP, SW10.C, SW10.MP, SW10.S2, SW11.C, SW11.MP, SW11.S2, U15.9 (VSS), U25.10 (VSS), U25.15 (A0), U25.16 (A1); also elsewhere on the board
unnamed: D16.1 (K), R120.2
unnamed: D17.1 (K), R121.2
unnamed: D18.1 (K), R122.2
unnamed: D19.1 (K), R123.2
unnamed: D20.1 (K), R124.2
unnamed: D21.1 (K), R125.2
unnamed: D22.1 (K), R126.2
unnamed: D23.1 (K), R127.2
unnamed: D24.1 (K), R128.2
unnamed: D25.1 (K), R129.2
unnamed: D26.1 (K), R130.2
unnamed: D27.1 (K), R131.2
unnamed: D28.1 (K), R132.2
unnamed: D29.1 (K), R133.2
unnamed: D30.1 (K), R134.2
unnamed: D31.1 (K), R135.2
unnamed: J11.1, R109.1, R193.2
unnamed: J13.1, R110.1, R192.2
unnamed: J15.1, R111.1, R197.2
unnamed: J17.1, Q18.3 (D)
unnamed: J20.1, Q19.3 (D)
unnamed: J22.1, Q20.3 (D)
unnamed: R112.1, R195.2, SW11.B
unnamed: R113.2, SW9.5
unnamed: R114.1, R194.2, SW11.A
unnamed: R115.1, R116.2, SW9.3
unnamed: R115.2, R190.1, SW9.2
unnamed: R139.2, RV13.2
unnamed: R175.2, R187.1, SW10.A
unnamed: R176.2, R185.1, SW10.B
unnamed: R199.2, R200.1, U15.5 (A0)
unnamed: R118.1, R119.2, U25.17 (A2)
VIN_5V: J18.1, J19.1, J21.1; also elsewhere on the board

Notes on the sheet:
CLK FREQ (INCREASE DECREASE, based on click)
STOP Button
I2C ADDRESS: 0x27
REC Button (Record mode keep it pressed)
GATE LENGTH (Staccato - legatto)
I2C ADDRESS: 0x20
DIRECTION: Forward, Pingpong, Backward, Random
START Button
ROTARY STEPS (1 to 16+)
USE max 16* 1mA LEDs

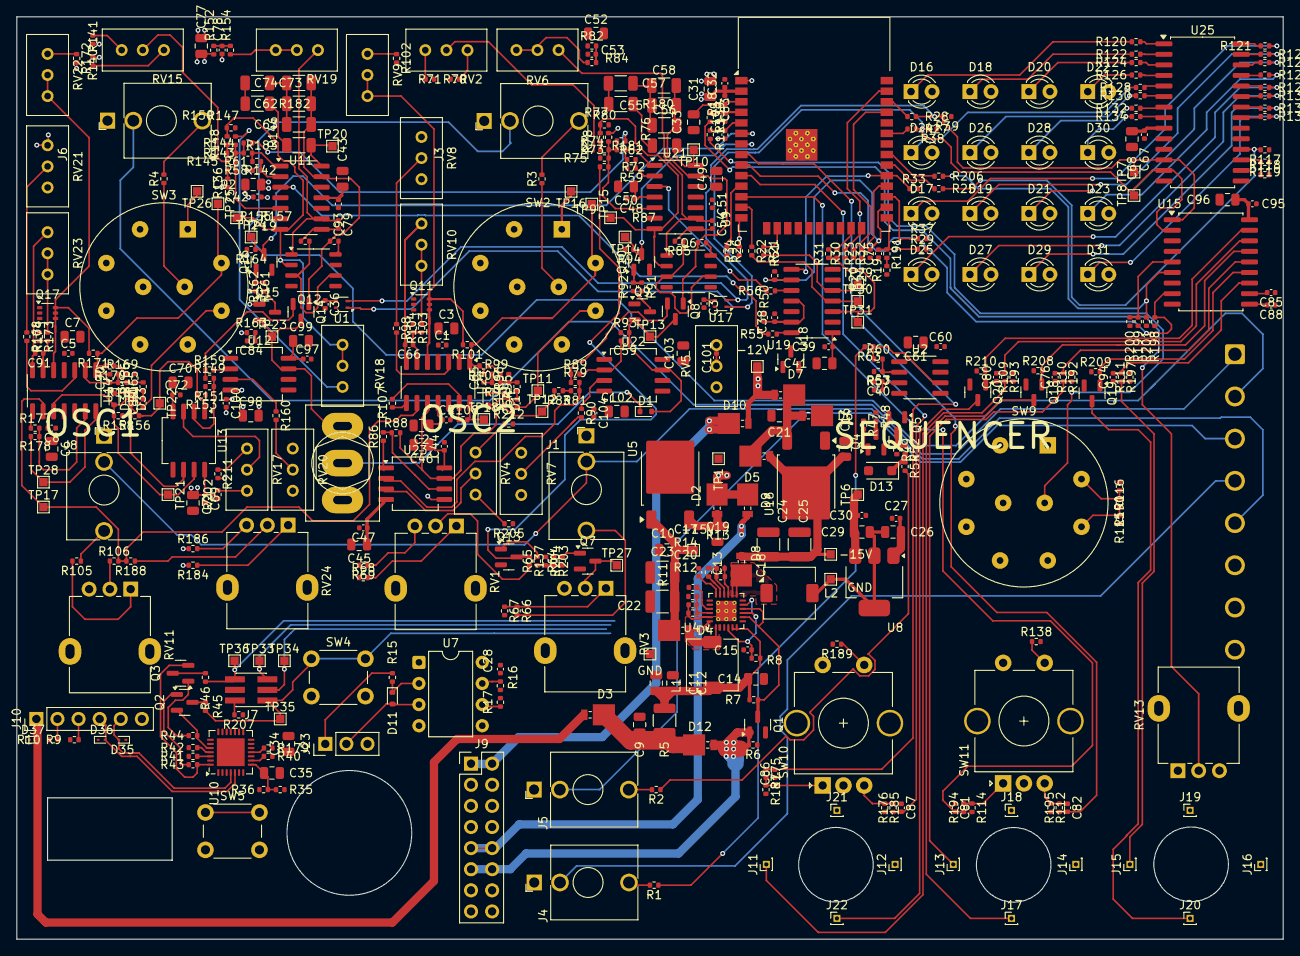
[picture p10: board midi_vco_module.kicad_pcb from above]

Board: 4 copper layers, 152.4 x 111.0 mm, 484 parts (1 on the bottom side), 276 nets.
