FabioCL/analog_synth/(commit log)

2025-08-27 added simulations as backup
    [lmx58b_lm2904b.dsn, lmx58b_lm2904b.opj]
2025-10-22 Added Hybrid core module
    [digital.kicad_sch, midi_vco_module.kicad_pcb, midi_vco_module.kicad_sch, osc1.kicad_sch, powersupply.kicad_sch, saw_pulse.kicad_sch, saw_triang.kicad_sch, sequencer_ui.kicad_sch]
2025-10-26 Schematic updated. Components Footprint assignment started. Waiting for components mechanical validation before starting layout.
    [digital.kicad_sch, midi_vco_module.kicad_sch, osc1.kicad_sch, powersupply.kicad_sch, saw_pulse.kicad_sch, saw_triang.kicad_sch, sequencer_ui.kicad_sch, signal_drivers.kicad_sch]
2025-11-10 - schematic updated - PN and footprints added
    [digital.kicad_sch, midi_vco_module.kicad_sch, osc1.kicad_sch, powersupply.kicad_sch, saw_pulse.kicad_sch, saw_triang.kicad_sch, sequencer_ui.kicad_sch, signal_drivers.kicad_sch]
2025-11-11 components placement (interface) components placement per section
    [digital.kicad_sch, midi_vco_module.kicad_pcb, midi_vco_module.kicad_sch, osc1.kicad_sch, powersupply.kicad_sch, saw_pulse.kicad_sch, saw_triang.kicad_sch, sequencer_ui.kicad_sch]
2025-11-14 - placement done - routing 60%
    [digital.kicad_sch, midi_vco_module.kicad_pcb, midi_vco_module.kicad_sch, osc1.kicad_sch, powersupply.kicad_sch, sequencer_ui.kicad_sch, signal_drivers.kicad_sch, triang_sine.kicad_sch]
2025-11-15 routing continued.
    [midi_vco_module.kicad_pcb, midi_vco_module.kicad_sch, osc1.kicad_sch]
